Team-UwU-Robotics/Team-UwU/README.md

# Team-UwU
Official Repository for Team UwU
