Team-UwU-Robotics/Team-UwU/Eagle PCB/Partlist/Part-List.xlsm

Sheet: Layer 1
Qty | Value | Device | Package | Parts | Description | PROD_ID | SF_ID | SF_SKU | VALUE.1 | Column1
3 |  | 74HC4067SSOP-24 | SSOP24 | MUX_L1, MUX_L2, MUX_L3
1 |  | CONN_021X02_NO_SILK | 1X02_NO_SILK | LDR | Multi connection point. Often used as Generic Header-pin footprint for 0.1 inch spaced/style header connections
1 |  | CONN_02LOCK | 1X02_LOCK | J1 | Multi connection point. Often used as Generic Header-pin footprint for 0.1 inch spaced/style header connections
1 |  | CONN_02POLAR | MOLEX-1X2 | LED | Multi connection point. Often used as Generic Header-pin footprint for 0.1 inch spaced/style header connections |  | PRT-09918
1 |  | CONN_03LOCK | 1X03_LOCK | ESC_IN | Multi connection point. Often used as Generic Header-pin footprint for 0.1 inch spaced/style header connections
1 |  | CONN_08LOCK | 1X08_LOCK | MOUSE | Multi connection point. Often used as Generic Header-pin footprint for 0.1 inch spaced/style header connections
36 |  | LIGHT_SENSORALS | ALS-PT19 | Q1, Q2, Q3, Q4, Q5, Q6, Q7, Q8, Q9, Q10, Q11, Q12, Q13, Q14, Q15, Q16, Q17, Q18, Q19, Q20, Q21, Q22, Q23, Q24, Q25, Q26, Q27, Q28, Q29, Q30, Q31, Q32, Q33, Q34, Q35, Q36 | Ambient Light Sensors - Phototransistors | IC-11836 | SEN-12566
2 |  | SN74LVC2G04DBVR | SOT23-6 | MU1, MU2
2 |  | SWITCH-SPDT-PTH-11.6X4.0MM-LOCK | SWITCH_SPDT_PTH_11.6X4.0MM_LOCK | LS1, S3 | Single Pole, Double Throw (SPDT) Switch | SWCH-08261 |  | COM-00102
2 |  | TPS54X0 | POWERPAD-SOIC-8 | U1, U2
7 | 0.1uF | CAPACITOR0603 | C0603 | 1C5, 1C9, 2C1, 2C2, 2C3, 3C1, 3C2
4 | 1.0uF | CAPACITOR0603 | C0603 | M1C3, M2C3, M3C3, M4C3
16 | 10k | RESISTOR0603 | R0603 | 1R1, 1R3, M1R8, M1R9, M1R11, M2R8, M2R9, M2R11, M3R8, M3R9, M3R11, M4R8, M4R9, M4R11, R1, R4
3 | 10nF | CAPACITOR0603 | C0603 | 1C3, 1C8, C4
2 | 10uH | INDUCTORSWPA8040 | SWPA8040 | 1L1, 1L2
12 | 18AWG | 18AWG | 18AWG | GND_M2A, GND_M2B, GND_M4A, GND_M4B, V_BATT_M1A, V_BATT_M1B, V_BATT_M2A, V_BATT_M2B, V_BATT_M3A, V_BATT_M3B, V_BATT_M4A, V_BATT_M4B
29 | 1k | RESISTOR0603 | R0603 | 2R1, 2R2, 2R3, M1R1, M1R2, M1R5, M1R6, M1R7, M1R10, M2R1, M2R2, M2R5, M2R6, M2R7, M2R10, M3R1, M3R2, M3R5, M3R6, M3R7, M3R10, M4R1, M4R2, M4R5, M4R6, M4R7, M4R10, R2, R3
14 | 1uF | CAPACITOR0603 | C0603 | 2C4, 2C5, 2C6, C1, C2, C3, C5, C8, LC1, LC2, LC3, LC4, LC5, LC6
2 | 220uF | 100UF-POLAR-EIA7343-10V-10%(TANT) | EIA7343 | 1C4, 1C7 | 100ÂµF polarized capacitors | CAP-07890 |  |  | 100uF
2 | 22pF | CAPACITOR0603 | C0603 | C6, C7
2 | 22uF | CAPACITOR1210 | C1210 | 1C2, 1C10
1 | 2M | RESISTOR0603 | R0603 | R6
1 | 2k | RESISTOR0603 | R0603 | LG_R2
1 | 3.24k | RESISTOR0603 | R0603 | 1R4
8 | 3.3k | RESISTOR0603 | R0603 | M1R3, M1R4, M2R3, M2R4, M3R3, M3R4, M4R3, M4R4
2 | 30Î©/1.8A | FERRITE_BEAD-0603 | 0603 | FB1, FB2 | Ferrite Bead (blocks, cores, rings, chokes, etc.) | NDUC-13805 |  |  | 30Î©/1.8A
4 | 33nF | CAPACITOR0603 | C0603 | M1C1, M2C1, M3C1, M4C1
36 | 3528LED | 3528LED | 3528 | LD1, LD2, LD3, LD4, LD5, LD6, LD7, LD8, LD9, LD10, LD11, LD12, LD13, LD14, LD15, LD16, LD17, LD18, LD19, LD20, LD21, LD22, LD23, LD24, LD25, LD26, LD27, LD28, LD29, LD30, LD31, LD32, LD33, LD34, LD35, LD36
3 | 3k | RESISTOR0603 | R0603 | 2R4, 2R5, 2R6
6 | 4.7k | RESISTOR0603 | R0603 | M1R12, M2R12, M3R12, M4R12, R8, R9
2 | 4.7uF | CAPACITOR0603 | C0603 | 1C1, 1C6
1 | 47 | RESISTOR0603 | R0603 | LR1
1 | 470 | RESISTOR0603 | R0603 | R5
1 | 5.9k | RESISTOR0603 | R0603 | 1R2
1 | 500k | RESISTOR0603 | R0603 | R7
4 | 680uF | 3.5MM_CAP | 3.5MM_CAP | M1C2, M2C2, M3C2, M4C2
1 | 8MHz | CRYSTALSMD-5X3.2-2PAD | CRYSTAL-SMD-5X3.2-2PAD | Y1 | Crystals (Generic)
1 | AO3402 | MOSFET-NCH-AO3404A | SOT23-3 | Q37 | N-channel MOSFETs | TRANS-12988 |  |  | 5.8A/30V/35mÎ©
4 | AOD482 | MOSFET-NCH-FDD8780 | DPAK | M1Q1, M2Q1, M3Q1, M4Q1 | N-channel MOSFETs | TRANS-09984 |  |  | 35A/25V/8.5mÎ©
4 | BLUE | LED-BLUE0603 | LED-0603 | M1D2, M2D2, M3D2, M4D2 | Blue SMD LED | DIO-08575 |  |  | BLUE
1 | BLUE | LED0603 | LED-0603 | D1 | LED (Generic)
1 | CONN_07X2 | CONN_07X2 | 2X7 | U$15
2 | MOMENTARY_SWITCH_4X3 | MOMENTARY_SWITCH_4X3 | MOMENTARY_SWITCH_4X3 | BOOT, RST
4 | RED | LED-RED0603 | LED-0603 | M1D1, M2D1, M3D1, M4D1 | Red SMD LED | DIO-00819 |  |  | RED
1 | SM06B-SRSS-TB | SM06B-SRSS-TB | SM06B-SRSS-TB | X2 | JST SH series header 1.00mm pitch disconnectable crimp style connectors, horizontal (side entry type), 6 pins
2 | SS54 | DIODE-SCHOTTKY | SMA-DIODE | 1D1, 1D2
1 | STM32F103CBT6 | STM32F103CBT6 | LQFP48 | U$2
4 | VNH5019 | VNH5019 | POWERSO-30 | M_BL, M_BR, M_FL, M_FR
5 | XT30PB-F | XT30PB-F | XT30PB-F | ESC_OUT, M1J1, M2J1, M3J1, M4J1
1 | XT60XT60PB-M | XT60XT60PB-M | XT60PB-M | U$1

Sheet: Layer 3
Qty | Value | Device | Package | Parts | Description | PROD_ID | SF_SKU | VALUE.1 | Column1
24 |  | CAPACITOR0603 | C0603 | 3C1, 3C2, 3C3, 3C4, 3C5, 3C6, 3C7, 3C8, 3C9, 3C10, 3C11, 3C12, 3C13, 3C14, 3C15, 3C16, 3C17, 3C18, 3C19, 3C20, 3C21, 3C22, 3C23, 3C24
1 |  | CONN_02LOCK | 1X02_LOCK | J1 | Multi connection point. Often used as Generic Header-pin footprint for 0.1 inch spaced/style header connections
1 |  | CONN_03LOCK | 1X03_LOCK | SERVO_IO | Multi connection point. Often used as Generic Header-pin footprint for 0.1 inch spaced/style header connections
2 |  | SWITCH-SPDT-PTH-11.6X4.0MM-LOCK | SWITCH_SPDT_PTH_11.6X4.0MM_LOCK | 3V3_PWR, 5V_PWR | Single Pole, Double Throw (SPDT) Switch | SWCH-08261 | COM-00102
6 | 10k | RESISTOR0603 | R0603 | R1, R4, R6, R7, R8, R9
2 | 1k | RESISTOR0603 | R0603 | R2, R3
4 | 1uF | CAPACITOR0603 | C0603 | C1, C2, C3, C5
2 | 22pF | CAPACITOR0603 | C0603 | C6, C7
2 | 4.7k | RESISTOR0603 | R0603 | R12, R13
1 | 470 | RESISTOR0603 | R0603 | R5
1 | 8MHz | CRYSTALSMD-5X3.2-2PAD | CRYSTAL-SMD-5X3.2-2PAD | Y1 | Crystals (Generic)
1 | AO3402 | MOSFET-NCH-AO3404A | SOT23-3 | Q2 | N-channel MOSFETs | TRANS-12988 |  | 5.8A/30V/35mÎ©
1 | BLUE | LED0603 | LED-0603 | D1 | LED (Generic)
1 | CONN_07X2 | CONN_07X2 | 2X7 | U$14
1 | DIP-04SMD | DIP-04SMD | DIPSWITCH-04-SMD | S1 | 4-Position DIP Switch
1 | HC-05 | HC-05 | HC-05 | BLUETOOTH
2 | MOMENTARY_SWITCH_4X3 | MOMENTARY_SWITCH_4X3 | MOMENTARY_SWITCH_4X3 | BOOT, RST
1 | OPENMV3 | OPENMV3 | OPENMV3 | U$8
1 | SM04B-SRSS-TB | SM04B-SRSS-TB | SM04B-SRSS-TB | 4TH_LAYER | JST SH series header 1.00mm pitch disconnectable crimp style connectors, horizontal (side entry type), 4 pins
1 | SM06B-SRSS-TB | SM06B-SRSS-TB | SM06B-SRSS-TB | X1 | JST SH series header 1.00mm pitch disconnectable crimp style connectors, horizontal (side entry type), 6 pins
1 | STM32F103CBT6 | STM32F103CBT6 | LQFP48 | STM32_IR
1 | TEENSY_3.5/3.6_NO_MIDDLE | TEENSY_3.5/3.6_NO_MIDDLE | TEENSY_3.5/3.6_NO_MIDDLE | U$1
24 | TSSP58038 | TSSP58038 | TSSP58038 | 3U1, 3U2, 3U3, 3U4, 3U5, 3U6, 3U7, 3U8, 3U9, 3U10, 3U11, 3U12, 3U13, 3U14, 3U15, 3U16, 3U17, 3U18, 3U19, 3U20, 3U21, 3U22, 3U23, 3U24

Sheet: Layer 4
Qty | Value | Device | Package | Parts | Description | PROD_ID | SF_SKU | Column1
16 |  | LED0603 | LED-0603 | 1D1, 1D2, 1D3, 1D4, 1D5, 1D6, 1D7, 1D8, 1D9, 1D10, 1D11, 1D12, 1D13, 1D14, 1D15, 1D16 | LED (Generic)
1 |  | SWITCH-SPDT-PTH-11.6X4.0MM-LOCK | SWITCH_SPDT_PTH_11.6X4.0MM_LOCK | 3V3_PWR | Single Pole, Double Throw (SPDT) Switch | SWCH-08261 | COM-00102
2 | 10k | RESISTOR0603 | R0603 | R1, R4
3 | 1k | RESISTOR0603 | R0603 | R2, R3, R5
4 | 1uF | CAPACITOR0603 | C0603 | C1, C2, C3, C5
2 | 22pF | CAPACITOR0603 | C0603 | C6, C7
8 | 470 | RESISTOR0603 | R0603 | 1R1, 1R2, 1R3, 1R4, 1R5, 1R6, 1R7, 1R8
1 | 8MHz | CRYSTALSMD-5X3.2-2PAD | CRYSTAL-SMD-5X3.2-2PAD | Y1 | Crystals (Generic)
1 | BLUE | LED0603 | LED-0603 | D1 | LED (Generic)
1 | BNO055 | BNO055 | BNO055 | COMPASS
3 | MOMENTARY_SWITCH_4X3 | MOMENTARY_SWITCH_4X3 | MOMENTARY_SWITCH_4X3 | BNO_RESET, BOOT, RST
1 | SM04B-SRSS-TB | SM04B-SRSS-TB | SM04B-SRSS-TB | 3RD_LAYER | JST SH series header 1.00mm pitch disconnectable crimp style connectors, horizontal (side entry type), 4 pins
1 | SM06B-SRSS-TB | SM06B-SRSS-TB | SM06B-SRSS-TB | X1 | JST SH series header 1.00mm pitch disconnectable crimp style connectors, horizontal (side entry type), 6 pins
1 | STM32F103CBT6 | STM32F103CBT6 | LQFP48 | STM32
4 | VL53L1X | VL53L1X | VL53L1X_SLANTEDPINS | TOF1, TOF2, TOF3, TOF4

Sheet: Layer 1-F
Part No | Description | Package | Unit Price | Qty | Total Qty | Total Price | Product Link | Remarks
100UF-POLAR-EIA7343-10V-10%(TANT) | 220uF | EIA7343 |  | 2 | 4
18AWG | 18AWG | 18AWG |  | 12 | 24
3.5MM_CAP | 680uF | 3.5MM_CAP |  | 4 | 8
3528LED | 3528LED | 3528 |  | 36 | 72
74HC4067SSOP-24 |  | SSOP24 |  | 3 | 6
CAPACITOR0603 | 0.1uF | C0603 |  | 7 | 14
CAPACITOR0603 | 1.0uF | C0603 |  | 4 | 8
CAPACITOR0603 | 10nF | C0603 |  | 3 | 6
CAPACITOR0603 | 1uF | C0603 |  | 14 | 28
CAPACITOR0603 | 22pF | C0603 |  | 2 | 4
CAPACITOR0603 | 33nF | C0603 |  | 4 | 8
CAPACITOR0603 | 4.7uF | C0603 |  | 2 | 4
CAPACITOR1210 | 22uF | C1210 |  | 2 | 4
CONN_021X02_NO_SILK |  | 1X02_NO_SILK |  | 1 | 2
CONN_02LOCK |  | 1X02_LOCK |  | 1 | 2
CONN_02POLAR |  | MOLEX-1X2 |  | 1 | 2
CONN_03LOCK |  | 1X03_LOCK |  | 1 | 2
CONN_07X2 | CONN_07X2 | 2X7 |  | 1 | 2
CONN_08LOCK |  | 1X08_LOCK |  | 1 | 2
CRYSTALSMD-5X3.2-2PAD | 8MHz | CRYSTAL-SMD-5X3.2-2PAD |  | 1 | 2
DIODE-SCHOTTKY | SS54 | SMA-DIODE |  | 2 | 4
FERRITE_BEAD-0603 | 30Î©/1.8A | 0603 |  | 2 | 4
INDUCTORSWPA8040 | 10uH | SWPA8040 |  | 2 | 4
LED0603 | BLUE | LED-0603 |  | 1 | 2
LED-BLUE0603 | BLUE | LED-0603 |  | 4 | 8
LED-RED0603 | RED | LED-0603 |  | 4 | 8
LIGHT_SENSORALS |  | ALS-PT19 |  | 36 | 72
MOMENTARY_SWITCH_4X3 | MOMENTARY_SWITCH_4X3 | MOMENTARY_SWITCH_4X3 |  | 2 | 4
MOSFET-NCH-AO3404A | AO3402 | SOT23-3 |  | 1 | 2
MOSFET-NCH-FDD8780 | AOD482 | DPAK |  | 4 | 8
RESISTOR0603 | 10k | R0603 |  | 16 | 32
RESISTOR0603 | 1k | R0603 |  | 29 | 58
RESISTOR0603 | 2M | R0603 |  | 1 | 2
RESISTOR0603 | 2k | R0603 |  | 1 | 2
RESISTOR0603 | 3.24k | R0603 |  | 1 | 2
RESISTOR0603 | 3.3k | R0603 |  | 8 | 16
RESISTOR0603 | 3k | R0603 |  | 3 | 6
RESISTOR0603 | 4.7k | R0603 |  | 6 | 12
RESISTOR0603 | 47 | R0603 |  | 1 | 2
RESISTOR0603 | 470 | R0603 |  | 1 | 2
RESISTOR0603 | 5.9k | R0603 |  | 1 | 2
RESISTOR0603 | 500k | R0603 |  | 1 | 2
SM06B-SRSS-TB | SM06B-SRSS-TB | SM06B-SRSS-TB |  | 1 | 2
SN74LVC2G04DBVR |  | SOT23-6 |  | 2 | 4
STM32F103CBT6 | STM32F103CBT6 | LQFP48 |  | 1 | 2
SWITCH-SPDT-PTH-11.6X4.0MM-LOCK |  | SWITCH_SPDT_PTH_11.6X4.0MM_LOCK |  | 2 | 4
TPS54X0 |  | POWERPAD-SOIC-8 |  | 2 | 4
VNH5019 | VNH5019 | POWERSO-30 |  | 4 | 8
XT30PB-F | XT30PB-F | XT30PB-F |  | 5 | 10
XT60XT60PB-M | XT60XT60PB-M | XT60PB-M |  | 1 | 2

Sheet: Layer 3-F
Part No | Description | Package | Unit Price | Qty | Total Qty | Total Price | Product Link | Remarks
CAPACITOR0603 |  | C0603 |  | 24 | 48
CAPACITOR0603 | 1uF | C0603 |  | 4 | 8
CAPACITOR0603 | 22pF | C0603 |  | 2 | 4
CONN_02LOCK |  | 1X02_LOCK |  | 1 | 2
CONN_03LOCK |  | 1X03_LOCK |  | 1 | 2
CONN_07X2 | CONN_07X2 | 2X7 |  | 1 | 2
CRYSTALSMD-5X3.2-2PAD | 8MHz | CRYSTAL-SMD-5X3.2-2PAD |  | 1 | 2
DIP-04SMD | DIP-04SMD | DIPSWITCH-04-SMD |  | 1 | 2
HC-05 | HC-05 | HC-05 |  | 1 | 2
LED0603 | BLUE | LED-0603 |  | 1 | 2
MOMENTARY_SWITCH_4X3 | MOMENTARY_SWITCH_4X3 | MOMENTARY_SWITCH_4X3 |  | 2 | 4
MOSFET-NCH-AO3404A | AO3402 | SOT23-3 |  | 1 | 2
OPENMV3 | OPENMV3 | OPENMV3 |  | 1 | 2
RESISTOR0603 | 10k | R0603 |  | 6 | 12
RESISTOR0603 | 1k | R0603 |  | 2 | 4
RESISTOR0603 | 4.7k | R0603 |  | 2 | 4
RESISTOR0603 | 470 | R0603 |  | 1 | 2
SM04B-SRSS-TB | SM04B-SRSS-TB | SM04B-SRSS-TB |  | 1 | 2
SM06B-SRSS-TB | SM06B-SRSS-TB | SM06B-SRSS-TB |  | 1 | 2
STM32F103CBT6 | STM32F103CBT6 | LQFP48 |  | 1 | 2
SWITCH-SPDT-PTH-11.6X4.0MM-LOCK |  | SWITCH_SPDT_PTH_11.6X4.0MM_LOCK |  | 2 | 4
TEENSY_3.5/3.6_NO_MIDDLE | TEENSY_3.5/3.6_NO_MIDDLE | TEENSY_3.5/3.6_NO_MIDDLE |  | 1 | 2
TSSP58038 | TSSP58038 | TSSP58038 |  | 24 | 48

Sheet: Layer 4-F
Part No | Description | Package | Unit Price | Qty | Total Qty | Total Price | Product Link | Remarks
BNO055 | BNO055 | BNO055 |  | 1 | 2
CAPACITOR0603 | 1uF | C0603 |  | 4 | 8
CAPACITOR0603 | 22pF | C0603 |  | 2 | 4
CRYSTALSMD-5X3.2-2PAD | 8MHz | CRYSTAL-SMD-5X3.2-2PAD |  | 1 | 2
LED0603 |  | LED-0603 |  | 16 | 32
LED0603 | BLUE | LED-0603 |  | 1 | 2
MOMENTARY_SWITCH_4X3 | MOMENTARY_SWITCH_4X3 | MOMENTARY_SWITCH_4X3 |  | 3 | 6
RESISTOR0603 | 10k | R0603 |  | 2 | 4
RESISTOR0603 | 1k | R0603 |  | 3 | 6
RESISTOR0603 | 470 | R0603 |  | 8 | 16
SM04B-SRSS-TB | SM04B-SRSS-TB | SM04B-SRSS-TB |  | 1 | 2
SM06B-SRSS-TB | SM06B-SRSS-TB | SM06B-SRSS-TB |  | 1 | 2
STM32F103CBT6 | STM32F103CBT6 | LQFP48 |  | 1 | 2
SWITCH-SPDT-PTH-11.6X4.0MM-LOCK |  | SWITCH_SPDT_PTH_11.6X4.0MM_LOCK |  | 1 | 2
VL53L1X | VL53L1X | VL53L1X_SLANTEDPINS |  | 4 | 8

Sheet: Sheet2
 |  |  |  | Values
Part No | Description | Package | Unit Price | Sum of Qty | Sum of Total Qty
100UF-POLAR-EIA7343-10V-10%(TANT) | 220uF | EIA7343 | (blank) | 2 | 4
100UF-POLAR-EIA7343-10V-10%(TANT) Total |  |  |  | 2 | 4
18AWG | 18AWG | 18AWG | (blank) | 12 | 24
18AWG Total |  |  |  | 12 | 24
3.5MM_CAP | 680uF | 3.5MM_CAP | (blank) | 4 | 8
3.5MM_CAP Total |  |  |  | 4 | 8
3528LED | 3528LED | 3528 | (blank) | 36 | 72
3528LED Total |  |  |  | 36 | 72
74HC4067SSOP-24 |  | SSOP24 | (blank) | 3 | 6
74HC4067SSOP-24 Total |  |  |  | 3 | 6
BNO055 | BNO055 | BNO055 | (blank) | 1 | 2
BNO055 Total |  |  |  | 1 | 2
CAPACITOR0603 |  | C0603 | (blank) | 24 | 48
 | 0.1uF | C0603 | (blank) | 7 | 14
 | 1.0uF | C0603 | (blank) | 4 | 8
 | 10nF | C0603 | (blank) | 3 | 6
 | 1uF | C0603 | (blank) | 22 | 44
 | 22pF | C0603 | (blank) | 6 | 12
 | 33nF | C0603 | (blank) | 4 | 8
 | 4.7uF | C0603 | (blank) | 2 | 4
CAPACITOR0603 Total |  |  |  | 72 | 144
CAPACITOR1210 | 22uF | C1210 | (blank) | 2 | 4
CAPACITOR1210 Total |  |  |  | 2 | 4
CONN_021X02_NO_SILK |  | 1X02_NO_SILK | (blank) | 1 | 2
CONN_021X02_NO_SILK Total |  |  |  | 1 | 2
CONN_02LOCK |  | 1X02_LOCK | (blank) | 2 | 4
CONN_02LOCK Total |  |  |  | 2 | 4
CONN_02POLAR |  | MOLEX-1X2 | (blank) | 1 | 2
CONN_02POLAR Total |  |  |  | 1 | 2
CONN_03LOCK |  | 1X03_LOCK | (blank) | 2 | 4
CONN_03LOCK Total |  |  |  | 2 | 4
CONN_07X2 | CONN_07X2 | 2X7 | (blank) | 2 | 4
CONN_07X2 Total |  |  |  | 2 | 4
CONN_08LOCK |  | 1X08_LOCK | (blank) | 1 | 2
CONN_08LOCK Total |  |  |  | 1 | 2
CRYSTALSMD-5X3.2-2PAD | 8MHz | CRYSTAL-SMD-5X3.2-2PAD | (blank) | 3 | 6
CRYSTALSMD-5X3.2-2PAD Total |  |  |  | 3 | 6
DIODE-SCHOTTKY | SS54 | SMA-DIODE | (blank) | 2 | 4
DIODE-SCHOTTKY Total |  |  |  | 2 | 4
DIP-04SMD | DIP-04SMD | DIPSWITCH-04-SMD | (blank) | 1 | 2
DIP-04SMD Total |  |  |  | 1 | 2
FERRITE_BEAD-0603 | 30Î©/1.8A | 0603 | (blank) | 2 | 4
FERRITE_BEAD-0603 Total |  |  |  | 2 | 4
HC-05 | HC-05 | HC-05 | (blank) | 1 | 2
HC-05 Total |  |  |  | 1 | 2
INDUCTORSWPA8040 | 10uH | SWPA8040 | (blank) | 2 | 4
INDUCTORSWPA8040 Total |  |  |  | 2 | 4
LED0603 |  | LED-0603 | (blank) | 16 | 32
 | BLUE | LED-0603 | (blank) | 3 | 6
LED0603 Total |  |  |  | 19 | 38
LED-BLUE0603 | BLUE | LED-0603 | (blank) | 4 | 8
LED-BLUE0603 Total |  |  |  | 4 | 8
LED-RED0603 | RED | LED-0603 | (blank) | 4 | 8
LED-RED0603 Total |  |  |  | 4 | 8
LIGHT_SENSORALS |  | ALS-PT19 | (blank) | 36 | 72
LIGHT_SENSORALS Total |  |  |  | 36 | 72
MOMENTARY_SWITCH_4X3 | MOMENTARY_SWITCH_4X3 | MOMENTARY_SWITCH_4X3 | (blank) | 7 | 14
MOMENTARY_SWITCH_4X3 Total |  |  |  | 7 | 14
MOSFET-NCH-AO3404A | AO3402 | SOT23-3 | (blank) | 2 | 4
MOSFET-NCH-AO3404A Total |  |  |  | 2 | 4
MOSFET-NCH-FDD8780 | AOD482 | DPAK | (blank) | 4 | 8
MOSFET-NCH-FDD8780 Total |  |  |  | 4 | 8
OPENMV3 | OPENMV3 | OPENMV3 | (blank) | 1 | 2
OPENMV3 Total |  |  |  | 1 | 2
RESISTOR0603 | 10k | R0603 | (blank) | 24 | 48
 | 1k | R0603 | (blank) | 34 | 68
 | 2k | R0603 | (blank) | 1 | 2
 | 2M | R0603 | (blank) | 1 | 2
 | 3.24k | R0603 | (blank) | 1 | 2
 | 3.3k | R0603 | (blank) | 8 | 16
 | 3k | R0603 | (blank) | 3 | 6
 | 4.7k | R0603 | (blank) | 8 | 16
 | 47 | R0603 | (blank) | 1 | 2
 | 470 | R0603 | (blank) | 10 | 20
 | 5.9k | R0603 | (blank) | 1 | 2
 | 500k | R0603 | (blank) | 1 | 2
RESISTOR0603 Total |  |  |  | 93 | 186
SM04B-SRSS-TB | SM04B-SRSS-TB | SM04B-SRSS-TB | (blank) | 2 | 4
SM04B-SRSS-TB Total |  |  |  | 2 | 4
SM06B-SRSS-TB | SM06B-SRSS-TB | SM06B-SRSS-TB | (blank) | 3 | 6
SM06B-SRSS-TB Total |  |  |  | 3 | 6
SN74LVC2G04DBVR |  | SOT23-6 | (blank) | 2 | 4
SN74LVC2G04DBVR Total |  |  |  | 2 | 4
STM32F103CBT6 | STM32F103CBT6 | LQFP48 | (blank) | 3 | 6
STM32F103CBT6 Total |  |  |  | 3 | 6
SWITCH-SPDT-PTH-11.6X4.0MM-LOCK |  | SWITCH_SPDT_PTH_11.6X4.0MM_LOCK | (blank) | 5 | 10
SWITCH-SPDT-PTH-11.6X4.0MM-LOCK Total |  |  |  | 5 | 10
TEENSY_3.5/3.6_NO_MIDDLE | TEENSY_3.5/3.6_NO_MIDDLE | TEENSY_3.5/3.6_NO_MIDDLE | (blank) | 1 | 2
TEENSY_3.5/3.6_NO_MIDDLE Total |  |  |  | 1 | 2
TPS54X0 |  | POWERPAD-SOIC-8 | (blank) | 2 | 4
TPS54X0 Total |  |  |  | 2 | 4
TSSP58038 | TSSP58038 | TSSP58038 | (blank) | 24 | 48
TSSP58038 Total |  |  |  | 24 | 48
VL53L1X | VL53L1X | VL53L1X_SLANTEDPINS | (blank) | 4 | 8
VL53L1X Total |  |  |  | 4 | 8
VNH5019 | VNH5019 | POWERSO-30 | (blank) | 4 | 8
VNH5019 Total |  |  |  | 4 | 8
XT30PB-F | XT30PB-F | XT30PB-F | (blank) | 5 | 10
XT30PB-F Total |  |  |  | 5 | 10
XT60XT60PB-M | XT60XT60PB-M | XT60PB-M | (blank) | 1 | 2
XT60XT60PB-M Total |  |  |  | 1 | 2
Grand Total |  |  |  | 378 | 756

Sheet: Sheet1
Part No | Description | Package | Unit Price | Qty | Total Qty | Total Price | Product Link | Remarks
100UF-POLAR-EIA7343-10V-10%(TANT) | 220uF | EIA7343 |  | 2 | 4
18AWG | 18AWG | 18AWG |  | 12 | 24
3.5MM_CAP | 680uF | 3.5MM_CAP |  | 4 | 8
3528LED | 3528LED | 3528 |  | 36 | 72
74HC4067SSOP-24 |  | SSOP24 |  | 3 | 6
CAPACITOR0603 | 0.1uF | C0603 |  | 7 | 14
CAPACITOR0603 | 1.0uF | C0603 |  | 4 | 8
CAPACITOR0603 | 10nF | C0603 |  | 3 | 6
CAPACITOR0603 | 1uF | C0603 |  | 14 | 28
CAPACITOR0603 | 22pF | C0603 |  | 2 | 4
CAPACITOR0603 | 33nF | C0603 |  | 4 | 8
CAPACITOR0603 | 4.7uF | C0603 |  | 2 | 4
CAPACITOR1210 | 22uF | C1210 |  | 2 | 4
CONN_021X02_NO_SILK |  | 1X02_NO_SILK |  | 1 | 2
CONN_02LOCK |  | 1X02_LOCK |  | 1 | 2
CONN_02POLAR |  | MOLEX-1X2 |  | 1 | 2
CONN_03LOCK |  | 1X03_LOCK |  | 1 | 2
CONN_07X2 | CONN_07X2 | 2X7 |  | 1 | 2
CONN_08LOCK |  | 1X08_LOCK |  | 1 | 2
CRYSTALSMD-5X3.2-2PAD | 8MHz | CRYSTAL-SMD-5X3.2-2PAD |  | 1 | 2
DIODE-SCHOTTKY | SS54 | SMA-DIODE |  | 2 | 4
FERRITE_BEAD-0603 | 30Î©/1.8A | 0603 |  | 2 | 4
INDUCTORSWPA8040 | 10uH | SWPA8040 |  | 2 | 4
LED0603 | BLUE | LED-0603 |  | 1 | 2
LED-BLUE0603 | BLUE | LED-0603 |  | 4 | 8
LED-RED0603 | RED | LED-0603 |  | 4 | 8
LIGHT_SENSORALS |  | ALS-PT19 |  | 36 | 72
MOMENTARY_SWITCH_4X3 | MOMENTARY_SWITCH_4X3 | MOMENTARY_SWITCH_4X3 |  | 2 | 4
MOSFET-NCH-AO3404A | AO3402 | SOT23-3 |  | 1 | 2
MOSFET-NCH-FDD8780 | AOD482 | DPAK |  | 4 | 8
RESISTOR0603 | 10k | R0603 |  | 16 | 32
RESISTOR0603 | 1k | R0603 |  | 29 | 58
RESISTOR0603 | 2M | R0603 |  | 1 | 2
RESISTOR0603 | 2k | R0603 |  | 1 | 2
RESISTOR0603 | 3.24k | R0603 |  | 1 | 2
RESISTOR0603 | 3.3k | R0603 |  | 8 | 16
RESISTOR0603 | 3k | R0603 |  | 3 | 6
RESISTOR0603 | 4.7k | R0603 |  | 6 | 12
RESISTOR0603 | 47 | R0603 |  | 1 | 2
RESISTOR0603 | 470 | R0603 |  | 1 | 2
RESISTOR0603 | 5.9k | R0603 |  | 1 | 2
RESISTOR0603 | 500k | R0603 |  | 1 | 2
SM06B-SRSS-TB | SM06B-SRSS-TB | SM06B-SRSS-TB |  | 1 | 2
SN74LVC2G04DBVR |  | SOT23-6 |  | 2 | 4
STM32F103CBT6 | STM32F103CBT6 | LQFP48 |  | 1 | 2
SWITCH-SPDT-PTH-11.6X4.0MM-LOCK |  | SWITCH_SPDT_PTH_11.6X4.0MM_LOCK |  | 2 | 4
TPS54X0 |  | POWERPAD-SOIC-8 |  | 2 | 4
VNH5019 | VNH5019 | POWERSO-30 |  | 4 | 8
XT30PB-F | XT30PB-F | XT30PB-F |  | 5 | 10
XT60XT60PB-M | XT60XT60PB-M | XT60PB-M |  | 1 | 2
CAPACITOR0603 |  | C0603 |  | 24 | 48
CAPACITOR0603 | 1uF | C0603 |  | 4 | 8
CAPACITOR0603 | 22pF | C0603 |  | 2 | 4
CONN_02LOCK |  | 1X02_LOCK |  | 1 | 2
CONN_03LOCK |  | 1X03_LOCK |  | 1 | 2
CONN_07X2 | CONN_07X2 | 2X7 |  | 1 | 2
CRYSTALSMD-5X3.2-2PAD | 8MHz | CRYSTAL-SMD-5X3.2-2PAD |  | 1 | 2
DIP-04SMD | DIP-04SMD | DIPSWITCH-04-SMD |  | 1 | 2
HC-05 | HC-05 | HC-05 |  | 1 | 2
LED0603 | BLUE | LED-0603 |  | 1 | 2
MOMENTARY_SWITCH_4X3 | MOMENTARY_SWITCH_4X3 | MOMENTARY_SWITCH_4X3 |  | 2 | 4
MOSFET-NCH-AO3404A | AO3402 | SOT23-3 |  | 1 | 2
OPENMV3 | OPENMV3 | OPENMV3 |  | 1 | 2
RESISTOR0603 | 10k | R0603 |  | 6 | 12
RESISTOR0603 | 1k | R0603 |  | 2 | 4
RESISTOR0603 | 4.7k | R0603 |  | 2 | 4
RESISTOR0603 | 470 | R0603 |  | 1 | 2
SM04B-SRSS-TB | SM04B-SRSS-TB | SM04B-SRSS-TB |  | 1 | 2
SM06B-SRSS-TB | SM06B-SRSS-TB | SM06B-SRSS-TB |  | 1 | 2
STM32F103CBT6 | STM32F103CBT6 | LQFP48 |  | 1 | 2
SWITCH-SPDT-PTH-11.6X4.0MM-LOCK |  | SWITCH_SPDT_PTH_11.6X4.0MM_LOCK |  | 2 | 4
TEENSY_3.5/3.6_NO_MIDDLE | TEENSY_3.5/3.6_NO_MIDDLE | TEENSY_3.5/3.6_NO_MIDDLE |  | 1 | 2
TSSP58038 | TSSP58038 | TSSP58038 |  | 24 | 48
BNO055 | BNO055 | BNO055 |  | 1 | 2
CAPACITOR0603 | 1uF | C0603 |  | 4 | 8
CAPACITOR0603 | 22pF | C0603 |  | 2 | 4
CRYSTALSMD-5X3.2-2PAD | 8MHz | CRYSTAL-SMD-5X3.2-2PAD |  | 1 | 2
LED0603 |  | LED-0603 |  | 16 | 32
LED0603 | BLUE | LED-0603 |  | 1 | 2
MOMENTARY_SWITCH_4X3 | MOMENTARY_SWITCH_4X3 | MOMENTARY_SWITCH_4X3 |  | 3 | 6
RESISTOR0603 | 10k | R0603 |  | 2 | 4
RESISTOR0603 | 1k | R0603 |  | 3 | 6
RESISTOR0603 | 470 | R0603 |  | 8 | 16
SM04B-SRSS-TB | SM04B-SRSS-TB | SM04B-SRSS-TB |  | 1 | 2
SM06B-SRSS-TB | SM06B-SRSS-TB | SM06B-SRSS-TB |  | 1 | 2
STM32F103CBT6 | STM32F103CBT6 | LQFP48 |  | 1 | 2
SWITCH-SPDT-PTH-11.6X4.0MM-LOCK |  | SWITCH_SPDT_PTH_11.6X4.0MM_LOCK |  | 1 | 2
VL53L1X | VL53L1X | VL53L1X_SLANTEDPINS |  | 4 | 8
