Team-UwU-Robotics/Team-UwU/Eagle PCB/Layer 3.brd

## EAGLE design Eagle PCB/Layer 3.brd (2021-03-01)

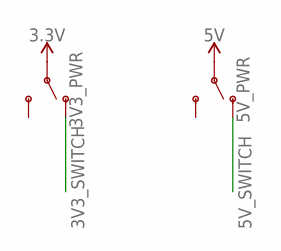
[picture p1: schematic Layer 3.sch, sheet 1]

Parts:
3V3_PWR, 5V_PWR: SWITCH-SPDT-PTH-11.6X4.0MM-LOCK; SWITCH_SPDT_PTH_11.6X4.0MM_LOCK

Connections:
3.3V: 3V3_PWR.2; also elsewhere on the board
3V3_SWITCH: 3V3_PWR.1 (O); also elsewhere on the board
5V: 5V_PWR.2; also elsewhere on the board
5V_SWITCH: 5V_PWR.1 (O); also elsewhere on the board

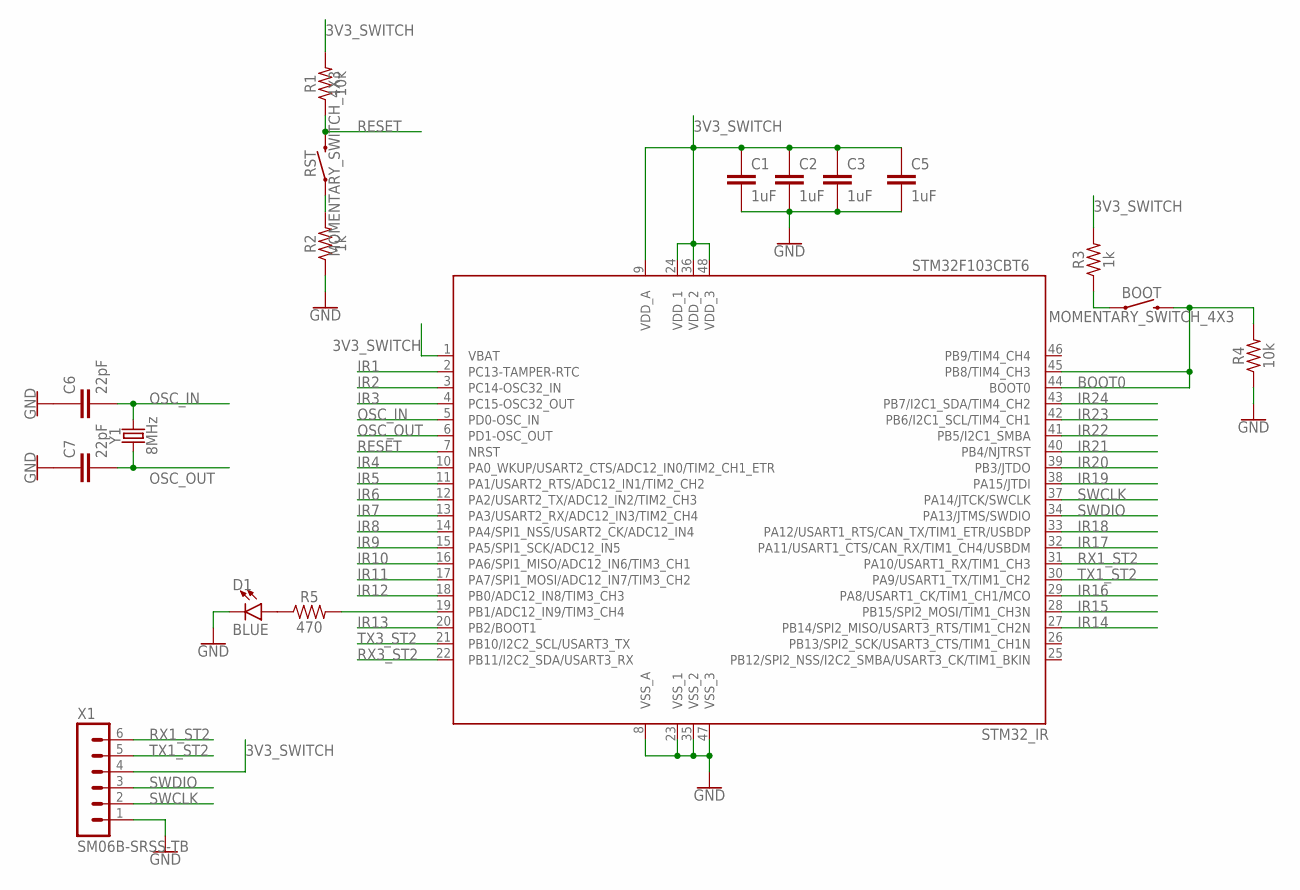
[picture p2: schematic Layer 3.sch, sheet 2]

Parts:
BOOT: MOMENTARY_SWITCH_4X3
C1, C2, C3, C5: 1uF; C0603
C6, C7: 22pF; C0603
D1: BLUE; LED-0603
R1, R4: 10k; R0603
R2, R3: 1k; R0603
R5: 470; R0603
RST: MOMENTARY_SWITCH_4X3
STM32_IR: STM32F103CBT6; LQFP48
X1: SM06B-SRSS-TB
Y1: 8MHz; CRYSTAL-SMD-5X3.2-2PAD

Connections:
3V3_SWITCH: C1.1, C2.1, C3.1, C5.2, R1.2, R3.2, STM32_IR.1 (VBAT), STM32_IR.9 (VDD_A), STM32_IR.24 (VDD_1), STM32_IR.36 (VDD_2), STM32_IR.48 (VDD_3), X1.4; also elsewhere on the board
BOOT0: BOOT.P$2 (2), R4.2, STM32_IR.44 (BOOT0), STM32_IR.45 (PB8/TIM4_CH3)
GND: C1.2, C2.2, C3.2, C5.1, C6.1, C7.1, D1.C, R2.1, R4.1, STM32_IR.8 (VSS_A), STM32_IR.23 (VSS_1), STM32_IR.35 (VSS_2), STM32_IR.47 (VSS_3), X1.1; also elsewhere on the board
IR1: STM32_IR.2 (PC13-TAMPER-RTC); also elsewhere on the board
IR2: STM32_IR.3 (PC14-OSC32_IN); also elsewhere on the board
IR3: STM32_IR.4 (PC15-OSC32_OUT); also elsewhere on the board
IR4: STM32_IR.10 (PA0_WKUP/USART2_CTS/ADC12_IN0/TIM2_CH1_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); also elsewhere on the board
IR5: STM32_IR.11 (PA1/USART2_RTS/ADC12_IN1/TIM2_CH2); also elsewhere on the board
IR6: STM32_IR.12 (PA2/USART2_TX/ADC12_IN2/TIM2_CH3); also elsewhere on the board
IR7: STM32_IR.13 (PA3/USART2_RX/ADC12_IN3/TIM2_CH4); also elsewhere on the board
IR8: STM32_IR.14 (PA4/SPI1_NSS/USART2_CK/ADC12_IN4); also elsewhere on the board
IR9: STM32_IR.15 (PA5/SPI1_SCK/ADC12_IN5); also elsewhere on the board
IR10: STM32_IR.16 (PA6/SPI1_MISO/ADC12_IN6/TIM3_CH1); also elsewhere on the board
IR11: STM32_IR.17 (PA7/SPI1_MOSI/ADC12_IN7/TIM3_CH2); also elsewhere on the board
IR12: STM32_IR.18 (PB0/ADC12_IN8/TIM3_CH3); also elsewhere on the board
IR13: STM32_IR.20 (PB2/BOOT1); also elsewhere on the board
IR14: STM32_IR.27 (PB14/SPI2_MISO/USART3_RTS/TIM1_CH2N); also elsewhere on the board
IR15: STM32_IR.28 (PB15/SPI2_MOSI/TIM1_CH3N); also elsewhere on the board
IR16: STM32_IR.29 (PA8/USART1_CK/TIM1_CH1/MCO); also elsewhere on the board
IR17: STM32_IR.32 (PA11/USART1_CTS/CAN_RX/TIM1_CH4/USBDM); also elsewhere on the board
IR18: STM32_IR.33 (PA12/USART1_RTS/CAN_TX/TIM1_ETR/USBDP); also elsewhere on the board
IR19: STM32_IR.38 (PA15/JTDI); also elsewhere on the board
IR20: STM32_IR.39 (PB3/JTDO); also elsewhere on the board
IR21: STM32_IR.40 (PB4/NJTRST); also elsewhere on the board
IR22: STM32_IR.41 (PB5/I2C1_SMBA); also elsewhere on the board
IR23: STM32_IR.42 (PB6/I2C1_SCL/TIM4_CH1); also elsewhere on the board
IR24: STM32_IR.43 (PB7/I2C1_SDA/TIM4_CH2); also elsewhere on the board
unnamed: R2.2, RST.P$1 (1)
unnamed: BOOT.P$1 (1), R3.1
unnamed: R5.2, STM32_IR.19 (PB1/ADC12_IN9/TIM3_CH4)
unnamed: D1.A, R5.1
OSC_IN: C6.2, STM32_IR.5 (PD0-OSC_IN), Y1.P$2 (2)
OSC_OUT: C7.2, STM32_IR.6 (PD1-OSC_OUT), Y1.P$1 (1)
RESET: R1.1, RST.P$2 (2), STM32_IR.7 (NRST)
RX1_ST2: STM32_IR.31 (PA10/USART1_RX/TIM1_CH3), X1.6; also elsewhere on the board
RX3_ST2: STM32_IR.22 (PB11/I2C2_SDA/USART3_RX)
SWCLK: STM32_IR.37 (PA14/JTCK/SWCLK), X1.2
SWDIO: STM32_IR.34 (PA13/JTMS/SWDIO), X1.3
TX1_ST2: STM32_IR.30 (PA9/USART1_TX/TIM1_CH2), X1.5; also elsewhere on the board
TX3_ST2: STM32_IR.21 (PB10/I2C2_SCL/USART3_TX)

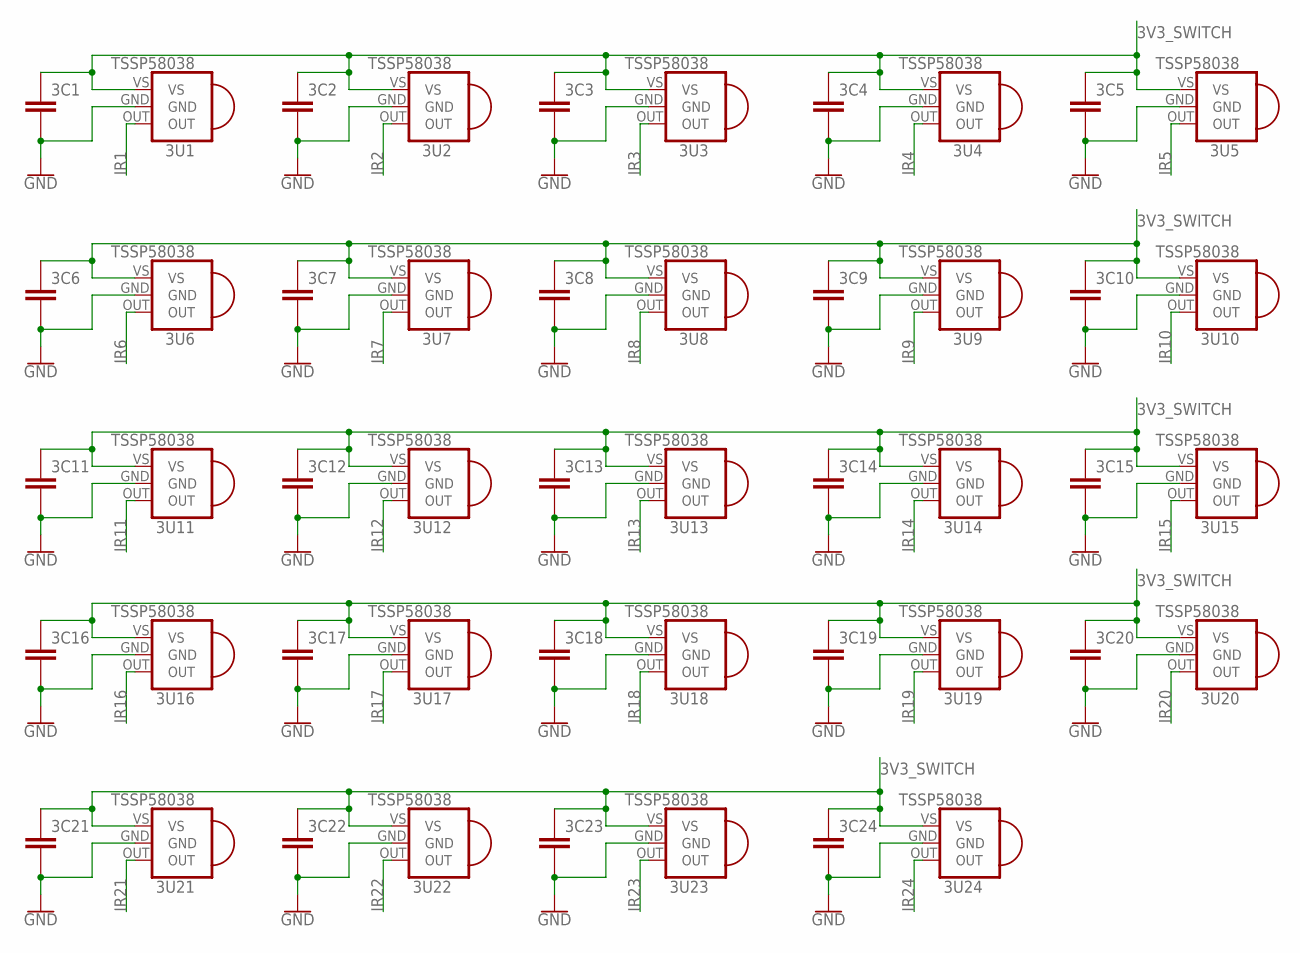
[picture p3: schematic Layer 3.sch, sheet 3]

Parts:
3C1, 3C2, 3C3, 3C4, 3C5, 3C6, 3C7, 3C8, 3C9, 3C10, 3C11, 3C12, 3C13, 3C14, 3C15, 3C16, 3C17, 3C18, 3C19, 3C20, 3C21, 3C22, 3C23, 3C24: CAPACITOR0603; C0603
3U1, 3U2, 3U3, 3U4, 3U5, 3U6, 3U7, 3U8, 3U9, 3U10, 3U11, 3U12, 3U13, 3U14, 3U15, 3U16, 3U17, 3U18, 3U19, 3U20, 3U21, 3U22, 3U23, 3U24: TSSP58038

Connections:
3V3_SWITCH: 3C1.1, 3C2.1, 3C3.1, 3C4.1, 3C5.1, 3C6.1, 3C7.1, 3C8.1, 3C9.1, 3C10.1, 3C11.1, 3C12.1, 3C13.1, 3C14.1, 3C15.1, 3C16.1, 3C17.1, 3C18.1, 3C19.1, 3C20.1, 3C21.1, 3C22.1, 3C23.1, 3C24.1, 3U1.VS, 3U2.VS, 3U3.VS, 3U4.VS, 3U5.VS, 3U6.VS, 3U7.VS, 3U8.VS, 3U9.VS, 3U10.VS, 3U11.VS, 3U12.VS, 3U13.VS, 3U14.VS, 3U15.VS, 3U16.VS, 3U17.VS, 3U18.VS, 3U19.VS, 3U20.VS, 3U21.VS, 3U22.VS, 3U23.VS, 3U24.VS; also elsewhere on the board
GND: 3C1.2, 3C2.2, 3C3.2, 3C4.2, 3C5.2, 3C6.2, 3C7.2, 3C8.2, 3C9.2, 3C10.2, 3C11.2, 3C12.2, 3C13.2, 3C14.2, 3C15.2, 3C16.2, 3C17.2, 3C18.2, 3C19.2, 3C20.2, 3C21.2, 3C22.2, 3C23.2, 3C24.2, 3U1.GND, 3U2.GND, 3U3.GND, 3U4.GND, 3U5.GND, 3U6.GND, 3U7.GND, 3U8.GND, 3U9.GND, 3U10.GND, 3U11.GND, 3U12.GND, 3U13.GND, 3U14.GND, 3U15.GND, 3U16.GND, 3U17.GND, 3U18.GND, 3U19.GND, 3U20.GND, 3U21.GND, 3U22.GND, 3U23.GND, 3U24.GND; also elsewhere on the board
IR1: 3U1.OUT; also elsewhere on the board
IR2: 3U2.OUT; also elsewhere on the board
IR3: 3U3.OUT; also elsewhere on the board
IR4: 3U4.OUT; also elsewhere on the board
IR5: 3U5.OUT; also elsewhere on the board
IR6: 3U6.OUT; also elsewhere on the board
IR7: 3U7.OUT; also elsewhere on the board
IR8: 3U8.OUT; also elsewhere on the board
IR9: 3U9.OUT; also elsewhere on the board
IR10: 3U10.OUT; also elsewhere on the board
IR11: 3U11.OUT; also elsewhere on the board
IR12: 3U12.OUT; also elsewhere on the board
IR13: 3U13.OUT; also elsewhere on the board
IR14: 3U14.OUT; also elsewhere on the board
IR15: 3U15.OUT; also elsewhere on the board
IR16: 3U16.OUT; also elsewhere on the board
IR17: 3U17.OUT; also elsewhere on the board
IR18: 3U18.OUT; also elsewhere on the board
IR19: 3U19.OUT; also elsewhere on the board
IR20: 3U20.OUT; also elsewhere on the board
IR21: 3U21.OUT; also elsewhere on the board
IR22: 3U22.OUT; also elsewhere on the board
IR23: 3U23.OUT; also elsewhere on the board
IR24: 3U24.OUT; also elsewhere on the board

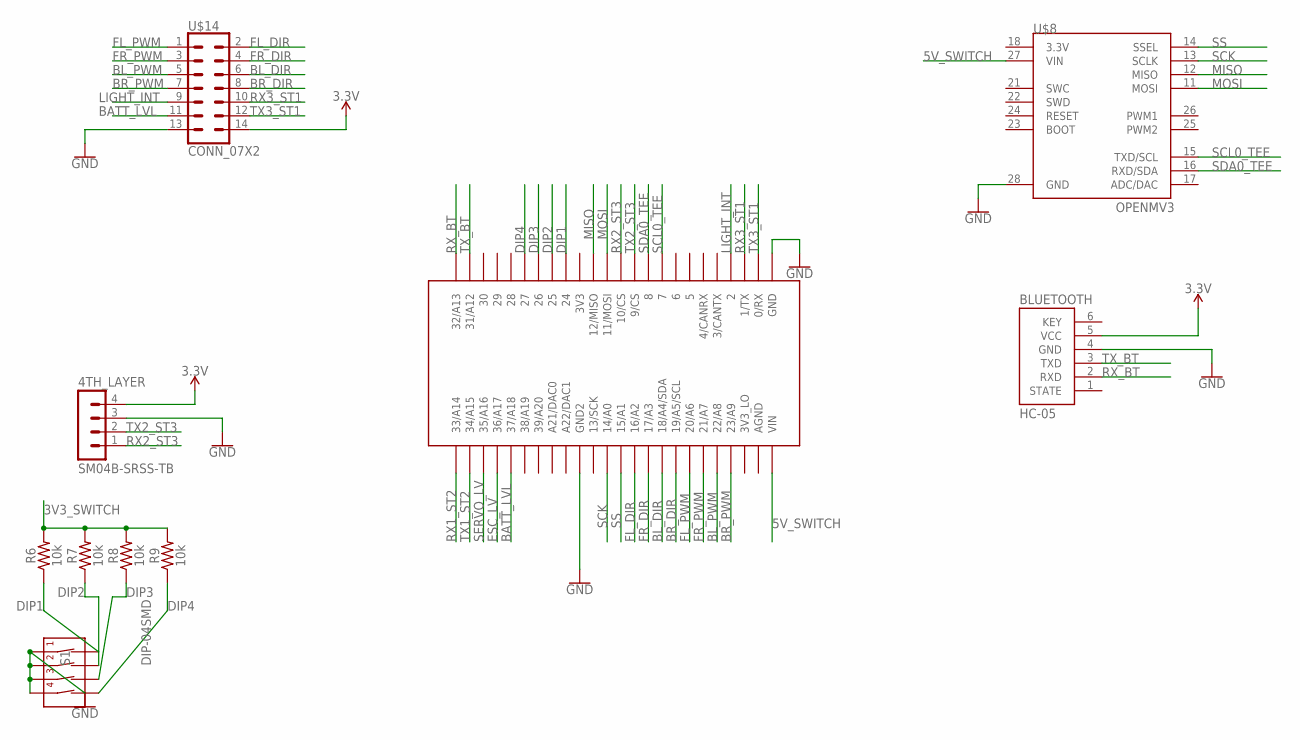
[picture p4: schematic Layer 3.sch, sheet 4]

Parts:
4TH_LAYER: SM04B-SRSS-TB
BLUETOOTH: HC-05
R6, R7, R8, R9: 10k; R0603
S1: DIP-04SMD; DIPSWITCH-04-SMD
U$1: TEENSY_3.5/3.6_NO_MIDDLE
U$8: OPENMV3
U$14: CONN_07X2; 2X7

Connections:
3.3V: 4TH_LAYER.4, BLUETOOTH.5 (VCC), U$14.14; also elsewhere on the board
3V3_SWITCH: R6.2, R7.2, R8.2, R9.2; also elsewhere on the board
5V_SWITCH: U$1.VIN, U$8.27 (VIN); also elsewhere on the board
BATT_LVL: U$1.37/A18, U$14.11
BL_DIR: U$1.18/A4/SDA, U$14.6
BL_PWM: U$1.22/A8, U$14.5
BR_DIR: U$1.19/A5/SCL, U$14.8
BR_PWM: U$1.23/A9, U$14.7
DIP1: R6.1, S1.1 (1A), U$1.24
DIP2: R7.1, S1.2 (2A), U$1.25
DIP3: R8.1, S1.3 (3A), U$1.26
DIP4: R9.1, S1.4 (4A), U$1.27
ESC_LV: U$1.36/A17; also elsewhere on the board
FL_DIR: U$1.16/A2, U$14.2
FL_PWM: U$1.20/A6, U$14.1
FR_DIR: U$1.17/A3, U$14.4
FR_PWM: U$1.21/A7, U$14.3
GND: 4TH_LAYER.3, BLUETOOTH.4 (GND), S1.5 (4B), S1.6 (3B), S1.7 (2B), S1.8 (1B), U$1.GND2, U$8.28 (GND), U$14.13; also elsewhere on the board
LIGHT_INT: U$1.2, U$14.9
MISO: U$1.12/MISO, U$8.12 (MISO)
MOSI: U$1.11/MOSI, U$8.11 (MOSI)
RX1_ST2: U$1.33/A14; also elsewhere on the board
RX2_ST3: 4TH_LAYER.1, U$1.10/CS
RX3_ST1: U$1.1/TX, U$14.10
RX_BT: BLUETOOTH.2 (RXD), U$1.32/A13
SCK: U$1.14/A0, U$8.13 (SCLK)
SCL0_TEE: U$1.7, U$8.15 (TXD/SCL)
SDA0_TEE: U$1.8, U$8.16 (RXD/SDA)
SERVO_LV: U$1.35/A16; also elsewhere on the board
SS: U$1.15/A1, U$8.14 (SSEL)
TX1_ST2: U$1.34/A15; also elsewhere on the board
TX2_ST3: 4TH_LAYER.2, U$1.9/CS
TX3_ST1: U$1.0/RX, U$14.12
TX_BT: BLUETOOTH.3 (TXD), U$1.31/A12

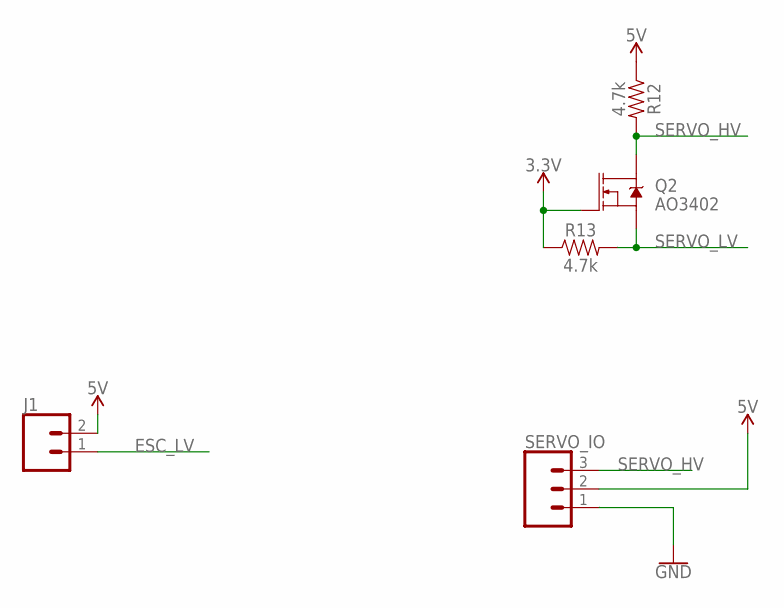
[picture p5: schematic Layer 3.sch, sheet 5, ESC + Servo]

Parts:
J1: CONN_02LOCK; 1X02_LOCK
Q2: AO3402; SOT23-3
R12, R13: 4.7k; R0603
SERVO_IO: CONN_03LOCK; 1X03_LOCK

Connections:
3.3V: Q2.1 (G), R13.1; also elsewhere on the board
5V: J1.2, R12.1, SERVO_IO.2; also elsewhere on the board
ESC_LV: J1.1; also elsewhere on the board
GND: SERVO_IO.1; also elsewhere on the board
SERVO_HV: Q2.3 (D), R12.2, SERVO_IO.3
SERVO_LV: Q2.2 (S), R13.2; also elsewhere on the board

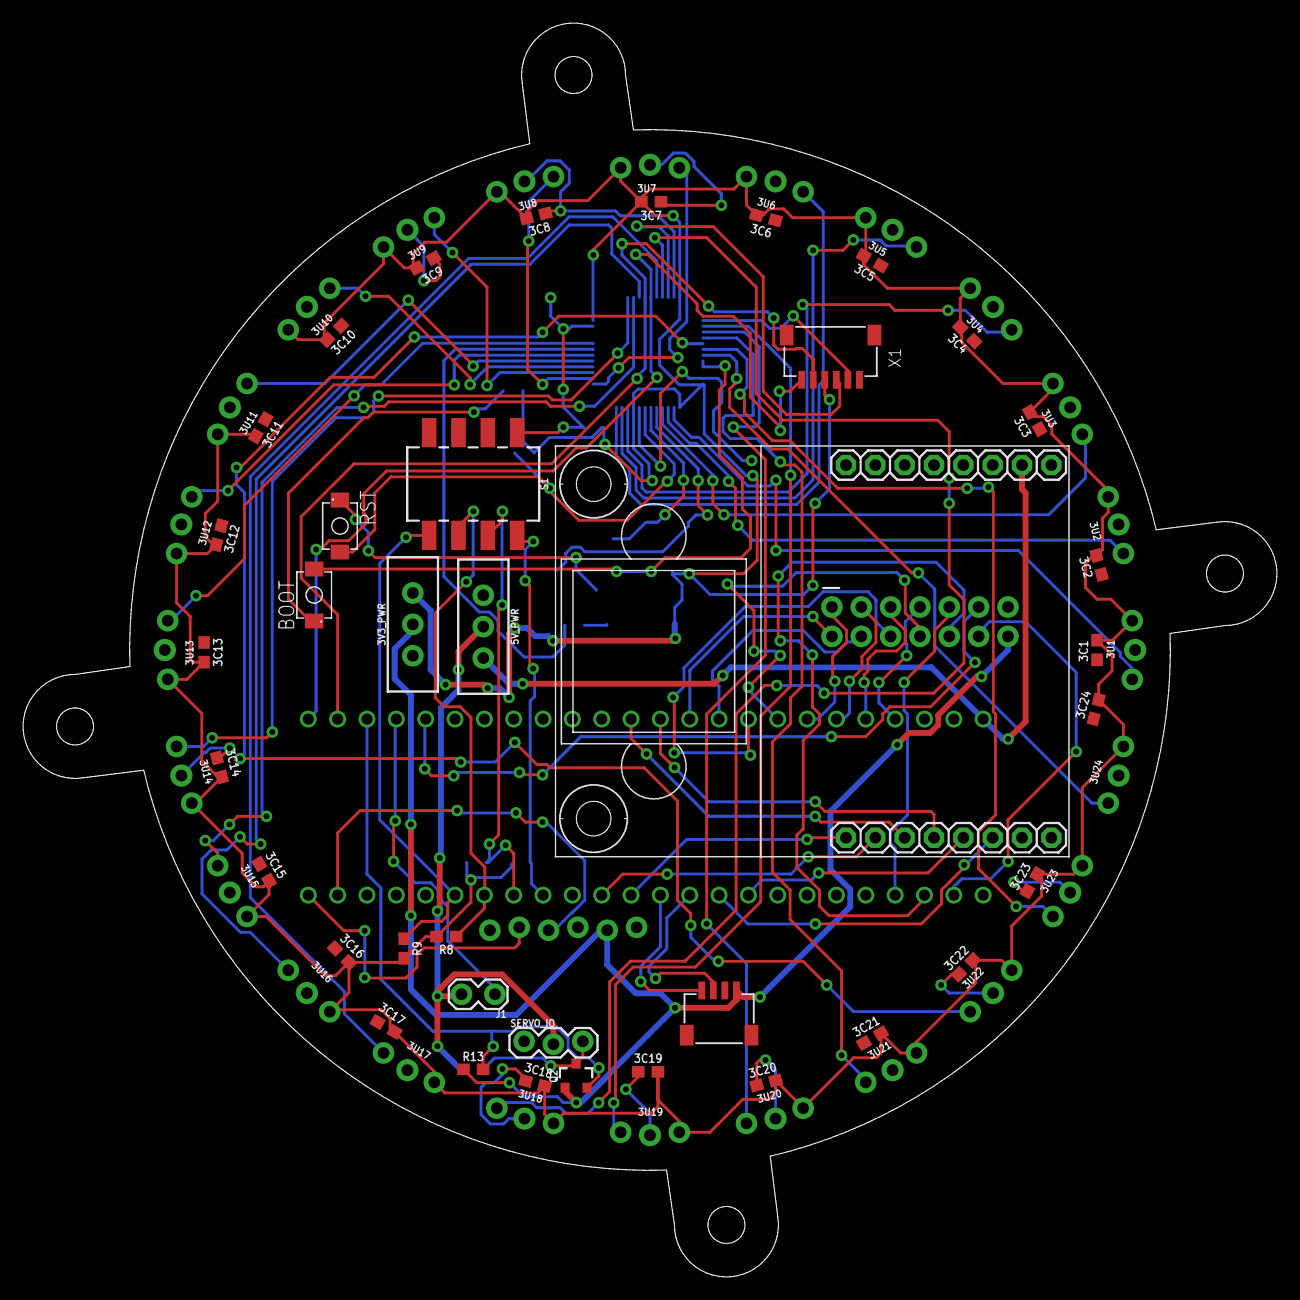
[picture p6: board Layer 3.brd from above]

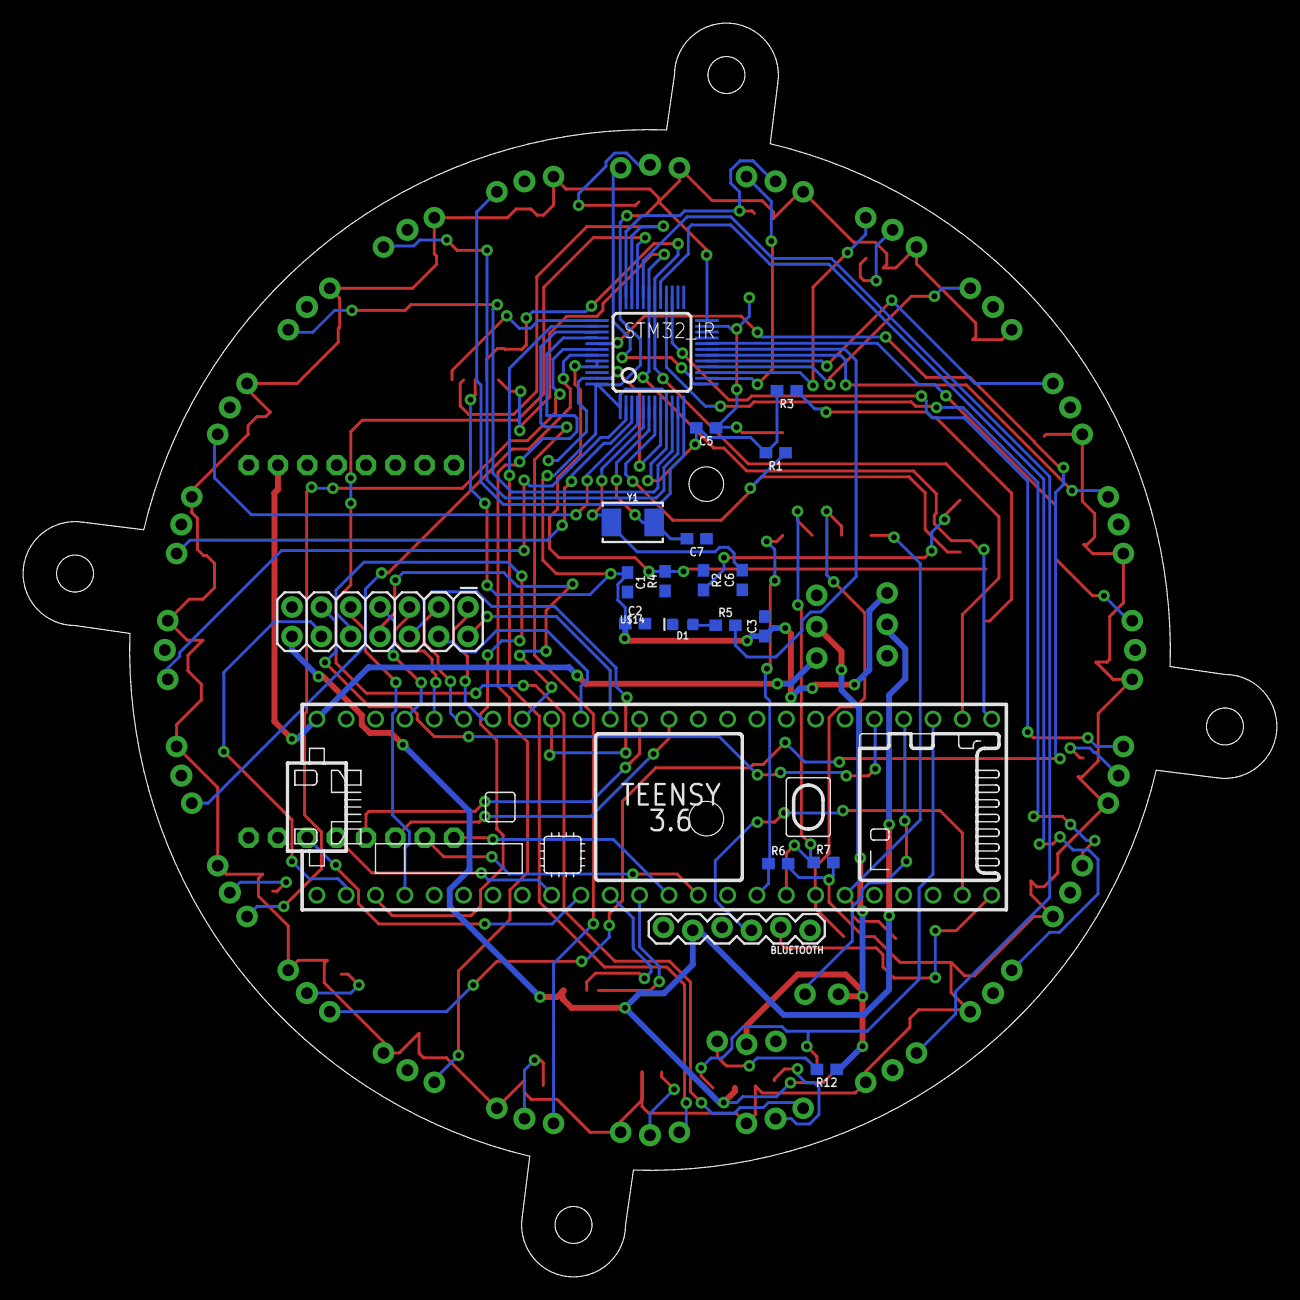
[picture p7: board Layer 3.brd from below]

Board: 2 copper layers, 108.5 x 108.5 mm, 82 parts (20 on the bottom side), 70 nets.
