Team-UwU-Robotics/Team-UwU/Eagle PCB/Layer 4.brd

## EAGLE design Eagle PCB/Layer 4.brd (2021-03-01)

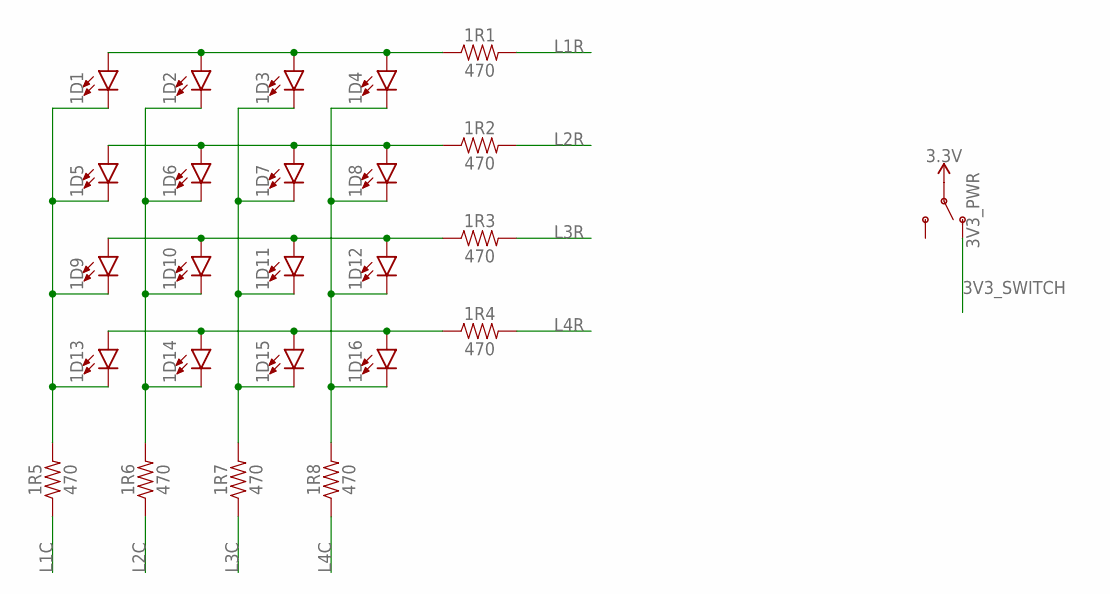
[picture p8: schematic Layer 4.sch, sheet 1, Light Sensor]

Parts:
1D1, 1D2, 1D3, 1D4, 1D5, 1D6, 1D7, 1D8, 1D9, 1D10, 1D11, 1D12, 1D13, 1D14, 1D15, 1D16: LED0603; LED-0603
1R1, 1R2, 1R3, 1R4, 1R5, 1R6, 1R7, 1R8: 470; R0603
3V3_PWR: SWITCH-SPDT-PTH-11.6X4.0MM-LOCK; SWITCH_SPDT_PTH_11.6X4.0MM_LOCK

Connections:
3.3V: 3V3_PWR.2; also elsewhere on the board
3V3_SWITCH: 3V3_PWR.1 (O); also elsewhere on the board
L1C: 1R5.1; also elsewhere on the board
L1R: 1R1.2; also elsewhere on the board
L2C: 1R6.1; also elsewhere on the board
L2R: 1R2.2; also elsewhere on the board
L3C: 1R7.1; also elsewhere on the board
L3R: 1R3.2; also elsewhere on the board
L4C: 1R8.1; also elsewhere on the board
L4R: 1R4.2; also elsewhere on the board
unnamed: 1D1.A, 1D2.A, 1D3.A, 1D4.A, 1R1.1
unnamed: 1D1.C, 1D5.C, 1D9.C, 1D13.C, 1R5.2
unnamed: 1D5.A, 1D6.A, 1D7.A, 1D8.A, 1R2.1
unnamed: 1D9.A, 1D10.A, 1D11.A, 1D12.A, 1R3.1
unnamed: 1D13.A, 1D14.A, 1D15.A, 1D16.A, 1R4.1
unnamed: 1D2.C, 1D6.C, 1D10.C, 1D14.C, 1R6.2
unnamed: 1D3.C, 1D7.C, 1D11.C, 1D15.C, 1R7.2
unnamed: 1D4.C, 1D8.C, 1D12.C, 1D16.C, 1R8.2

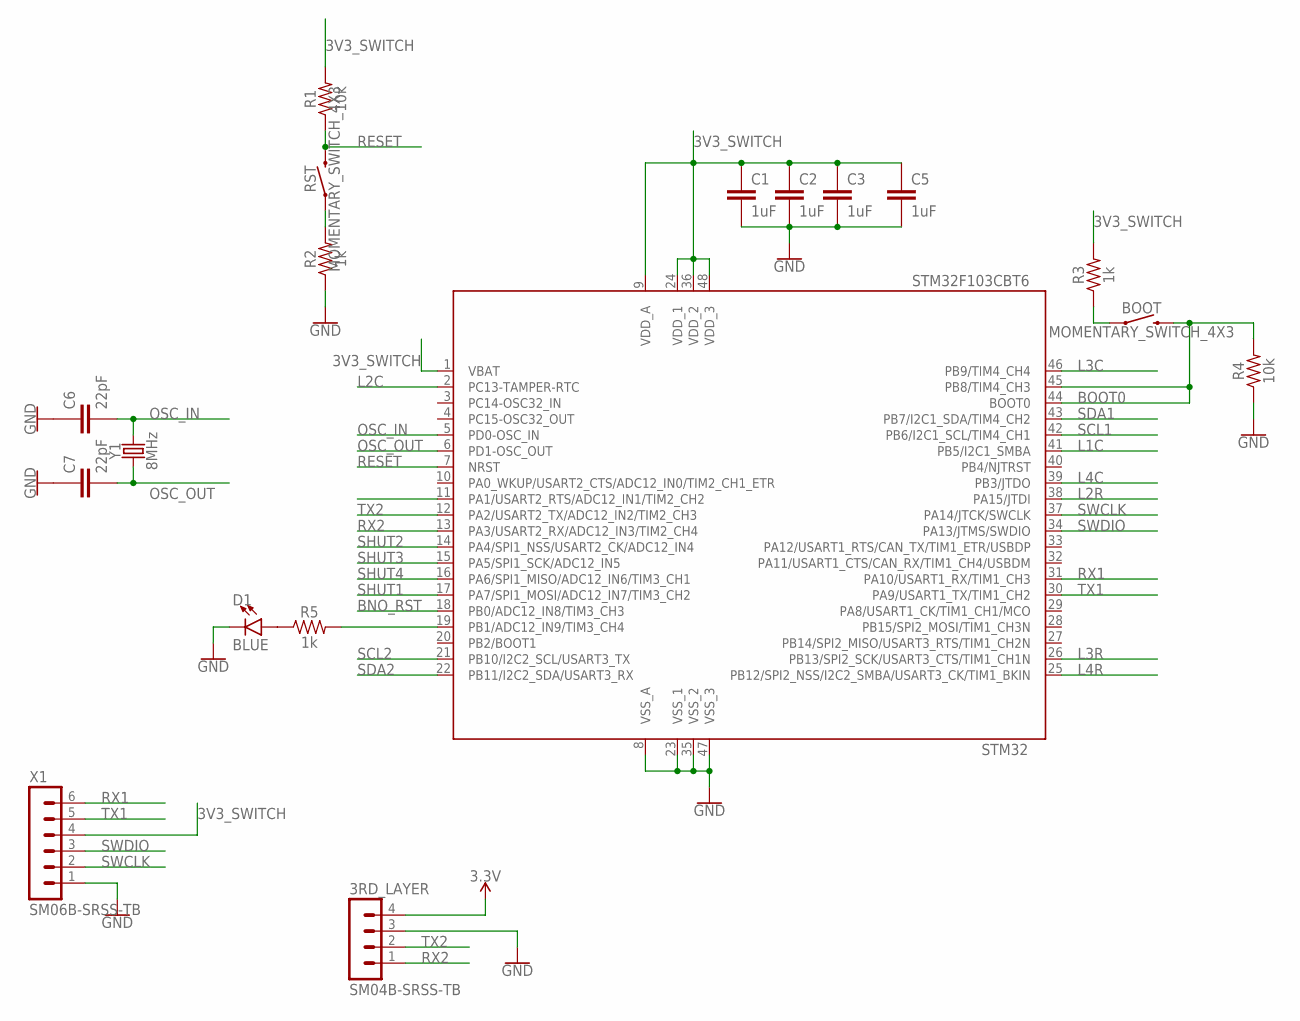
[picture p9: schematic Layer 4.sch, sheet 2, STEM32]

Parts:
3RD_LAYER: SM04B-SRSS-TB
BOOT: MOMENTARY_SWITCH_4X3
C1, C2, C3, C5: 1uF; C0603
C6, C7: 22pF; C0603
D1: BLUE; LED-0603
R1, R4: 10k; R0603
R2, R3, R5: 1k; R0603
RST: MOMENTARY_SWITCH_4X3
STM32: STM32F103CBT6; LQFP48
X1: SM06B-SRSS-TB
Y1: 8MHz; CRYSTAL-SMD-5X3.2-2PAD

Connections:
3.3V: 3RD_LAYER.4; also elsewhere on the board
3V3_SWITCH: C1.1, C2.1, C3.1, C5.2, R1.2, R3.2, STM32.1 (VBAT), STM32.9 (VDD_A), STM32.24 (VDD_1), STM32.36 (VDD_2), STM32.48 (VDD_3), X1.4; also elsewhere on the board
BNO_RST: STM32.18 (PB0/ADC12_IN8/TIM3_CH3); also elsewhere on the board
BOOT0: BOOT.P$2 (2), R4.2, STM32.44 (BOOT0), STM32.45 (PB8/TIM4_CH3)
GND: 3RD_LAYER.3, C1.2, C2.2, C3.2, C5.1, C6.1, C7.1, D1.C, R2.1, R4.1, STM32.8 (VSS_A), STM32.23 (VSS_1), STM32.35 (VSS_2), STM32.47 (VSS_3), X1.1; also elsewhere on the board
L1C: STM32.41 (PB5/I2C1_SMBA); also elsewhere on the board
L1R: STM32.11 (PA1/USART2_RTS/ADC12_IN1/TIM2_CH2); also elsewhere on the board
L2C: STM32.2 (PC13-TAMPER-RTC); also elsewhere on the board
L2R: STM32.38 (PA15/JTDI); also elsewhere on the board
L3C: STM32.46 (PB9/TIM4_CH4); also elsewhere on the board
L3R: STM32.26 (PB13/SPI2_SCK/USART3_CTS/TIM1_CH1N); also elsewhere on the board
L4C: STM32.39 (PB3/JTDO); also elsewhere on the board
L4R: STM32.25 (PB12/SPI2_NSS/I2C2_SMBA/USART3_CK/TIM1_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); also elsewhere on the board
unnamed: R2.2, RST.P$1 (1)
unnamed: BOOT.P$1 (1), R3.1
unnamed: R5.2, STM32.19 (PB1/ADC12_IN9/TIM3_CH4)
unnamed: D1.A, R5.1
OSC_IN: C6.2, STM32.5 (PD0-OSC_IN), Y1.P$2 (2)
OSC_OUT: C7.2, STM32.6 (PD1-OSC_OUT), Y1.P$1 (1)
RESET: R1.1, RST.P$2 (2), STM32.7 (NRST)
RX1: STM32.31 (PA10/USART1_RX/TIM1_CH3), X1.6
RX2: 3RD_LAYER.1, STM32.13 (PA3/USART2_RX/ADC12_IN3/TIM2_CH4)
SCL1: STM32.42 (PB6/I2C1_SCL/TIM4_CH1); also elsewhere on the board
SCL2: STM32.21 (PB10/I2C2_SCL/USART3_TX); also elsewhere on the board
SDA1: STM32.43 (PB7/I2C1_SDA/TIM4_CH2); also elsewhere on the board
SDA2: STM32.22 (PB11/I2C2_SDA/USART3_RX); also elsewhere on the board
SHUT1: STM32.17 (PA7/SPI1_MOSI/ADC12_IN7/TIM3_CH2); also elsewhere on the board
SHUT2: STM32.14 (PA4/SPI1_NSS/USART2_CK/ADC12_IN4); also elsewhere on the board
SHUT3: STM32.15 (PA5/SPI1_SCK/ADC12_IN5); also elsewhere on the board
SHUT4: STM32.16 (PA6/SPI1_MISO/ADC12_IN6/TIM3_CH1); also elsewhere on the board
SWCLK: STM32.37 (PA14/JTCK/SWCLK), X1.2
SWDIO: STM32.34 (PA13/JTMS/SWDIO), X1.3
TX1: STM32.30 (PA9/USART1_TX/TIM1_CH2), X1.5
TX2: 3RD_LAYER.2, STM32.12 (PA2/USART2_TX/ADC12_IN2/TIM2_CH3)

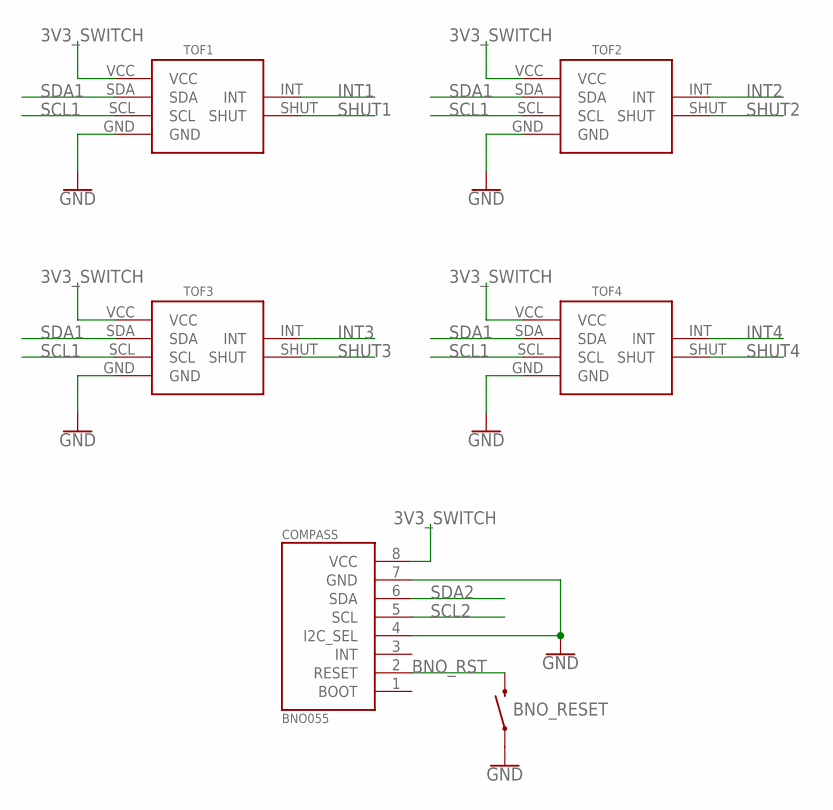
[picture p10: schematic Layer 4.sch, sheet 3, Sensors]

Parts:
BNO_RESET: MOMENTARY_SWITCH_4X3
COMPASS: BNO055
TOF1, TOF2, TOF3, TOF4: VL53L1X; VL53L1X_SLANTEDPINS

Connections:
3V3_SWITCH: COMPASS.8 (VCC), TOF1.VCC, TOF2.VCC, TOF3.VCC, TOF4.VCC; also elsewhere on the board
BNO_RST: BNO_RESET.P$2 (2), COMPASS.2 (RESET); also elsewhere on the board
GND: BNO_RESET.P$1 (1), COMPASS.4 (I2C_SEL), COMPASS.7 (GND), TOF1.GND, TOF2.GND, TOF3.GND, TOF4.GND; also elsewhere on the board
INT1: TOF1.INT
INT2: TOF2.INT
INT3: TOF3.INT
INT4: TOF4.INT
SCL1: TOF1.SCL, TOF2.SCL, TOF3.SCL, TOF4.SCL; also elsewhere on the board
SCL2: COMPASS.5 (SCL); also elsewhere on the board
SDA1: TOF1.SDA, TOF2.SDA, TOF3.SDA, TOF4.SDA; also elsewhere on the board
SDA2: COMPASS.6 (SDA); also elsewhere on the board
SHUT1: TOF1.SHUT; also elsewhere on the board
SHUT2: TOF2.SHUT; also elsewhere on the board
SHUT3: TOF3.SHUT; also elsewhere on the board
SHUT4: TOF4.SHUT; also elsewhere on the board

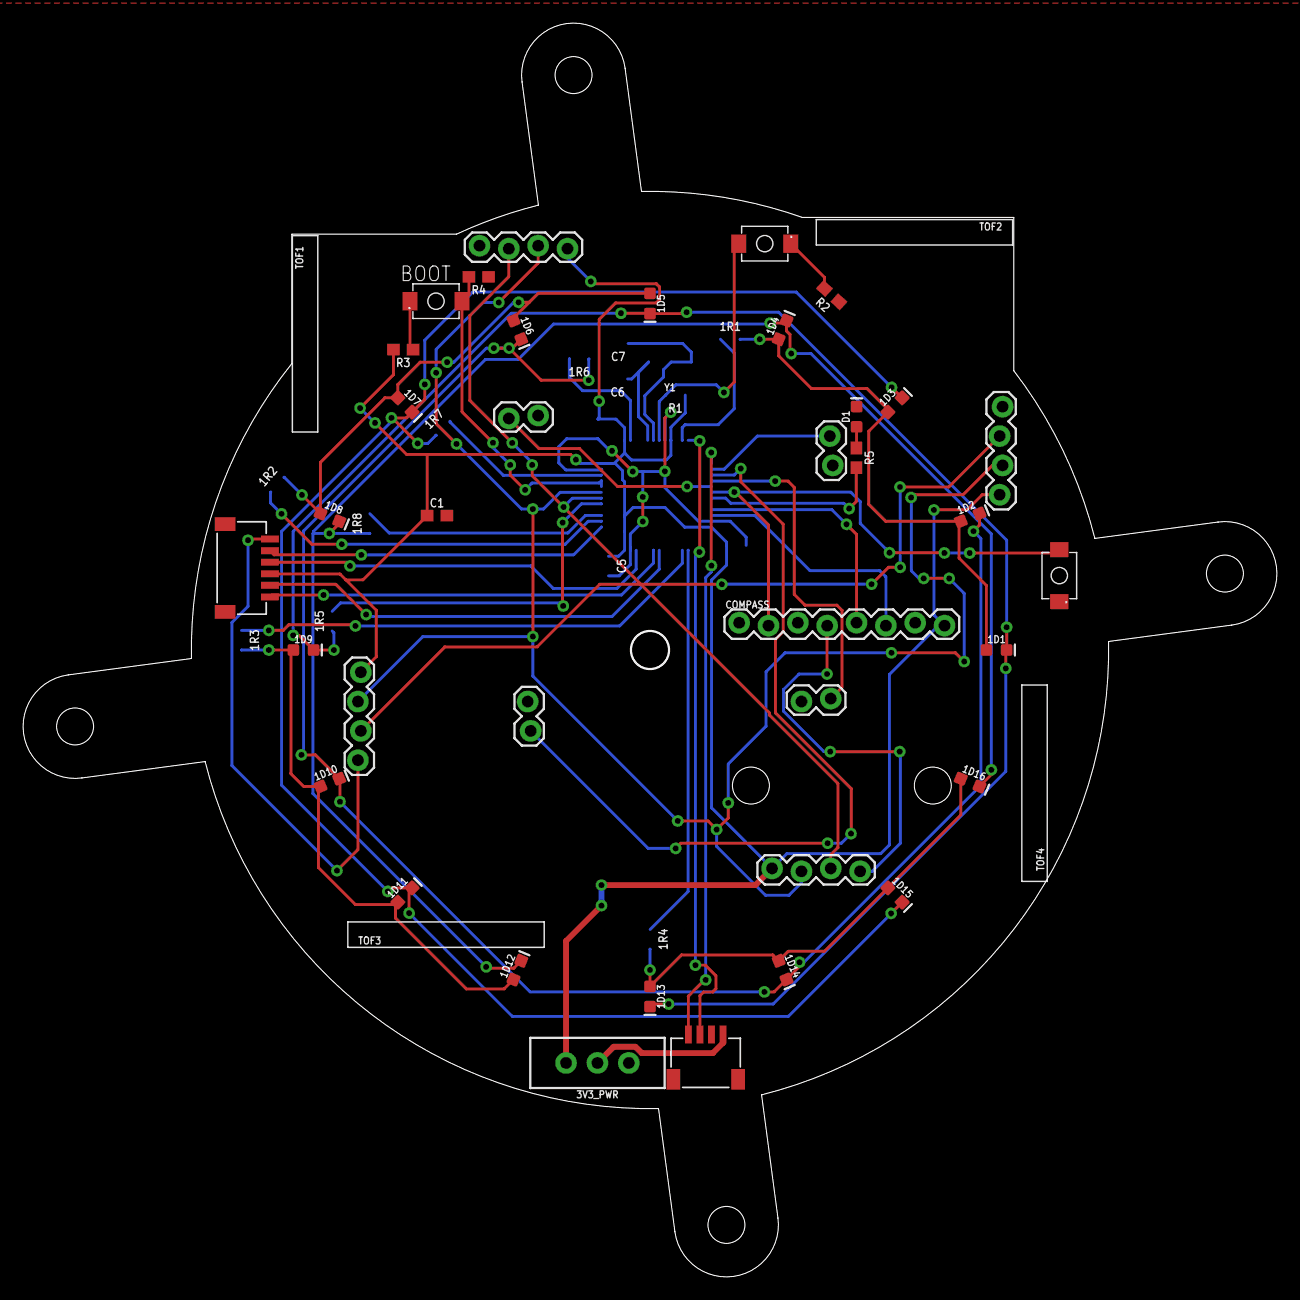
[picture p11: board Layer 4.brd from above]

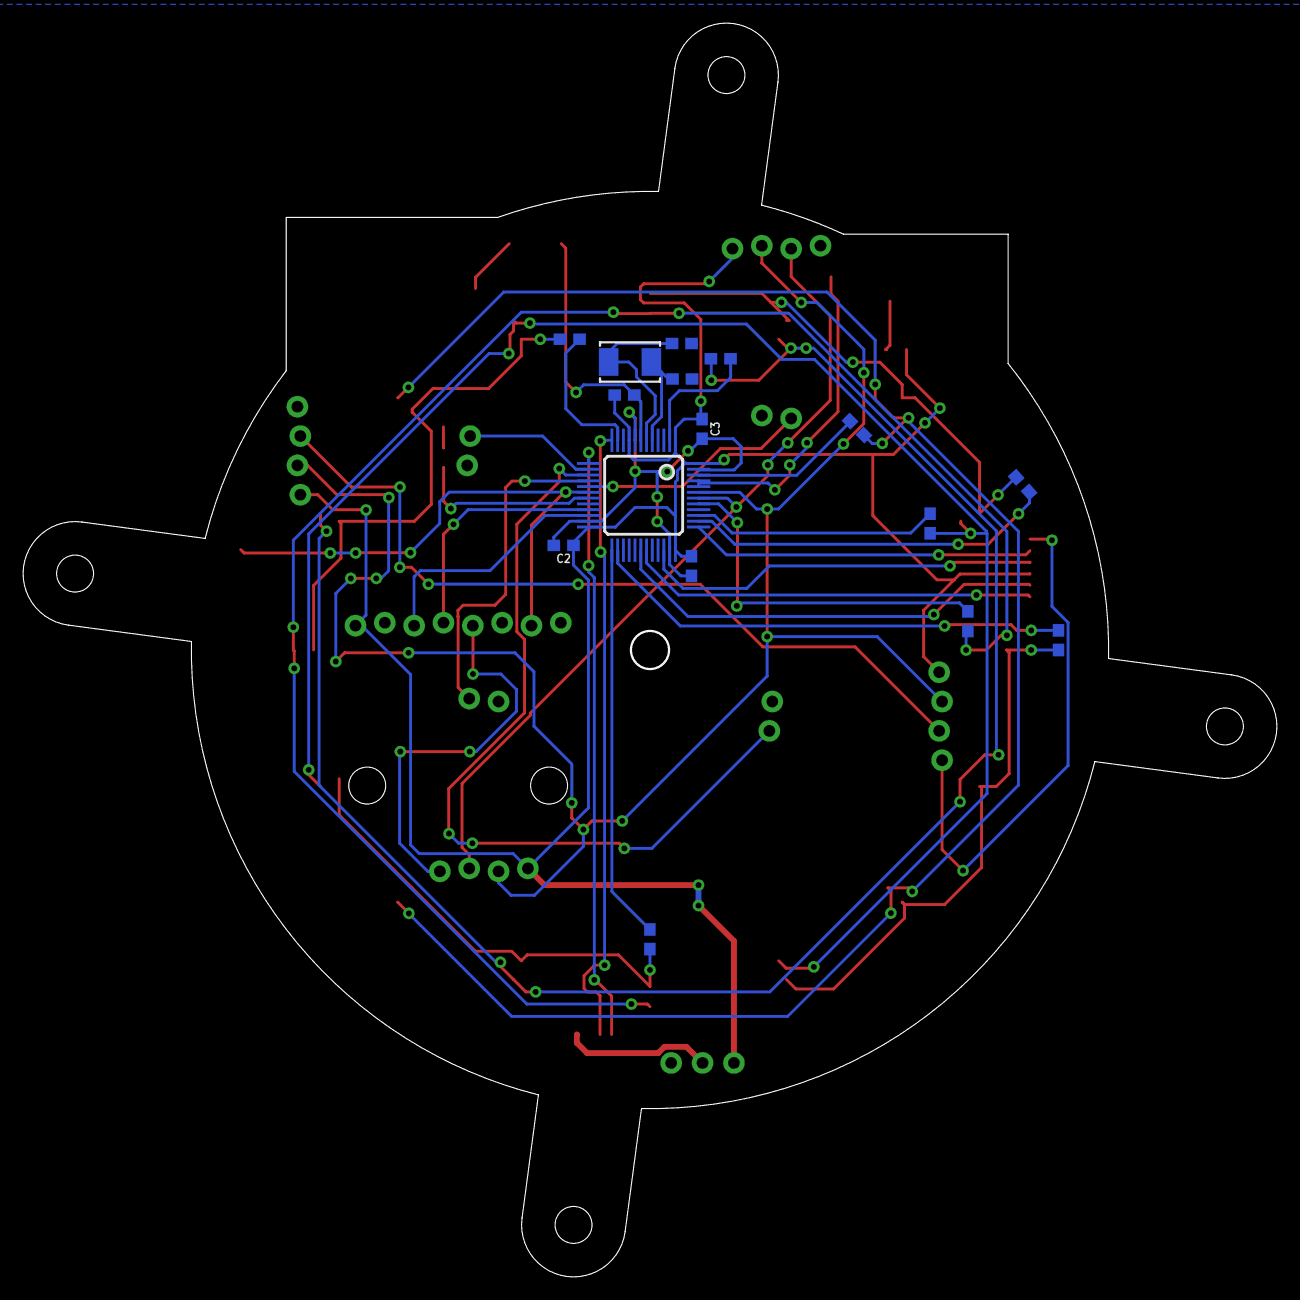
[picture p12: board Layer 4.brd from below]

Board: 2 copper layers, 108.5 x 108.5 mm, 49 parts (16 on the bottom side), 42 nets.
