Team-UwU-Robotics/Team-UwU/Eagle PCB/Layer 1.brd

## EAGLE design Eagle PCB/Layer 1.brd (2021-03-01)

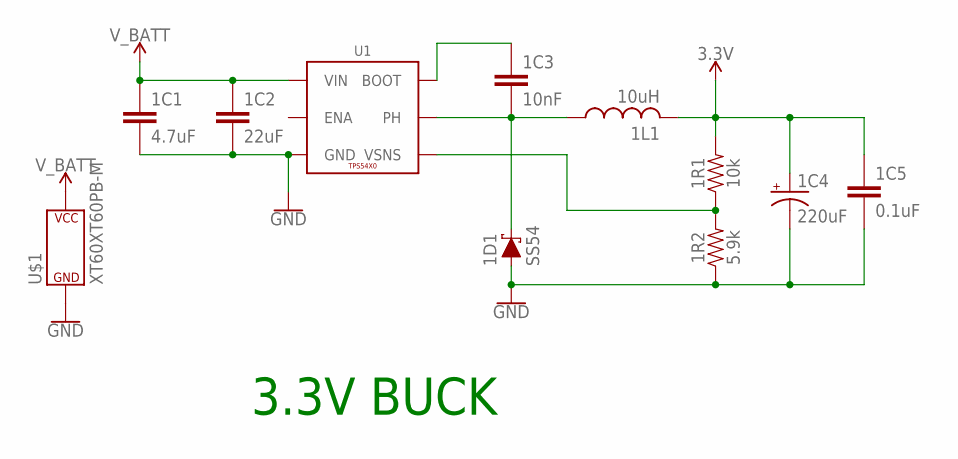
[picture p13: schematic Layer 1.sch, sheet 1]

Parts:
1C1: 4.7uF; C0603
1C2: 22uF; C1210
1C3: 10nF; C0603
1C4: 220uF; EIA7343
1C5: 0.1uF; C0603
1D1: SS54; SMA-DIODE
1L1: 10uH; SWPA8040
1R1: 10k; R0603
1R2: 5.9k; R0603
U1: TPS54X0; POWERPAD-SOIC-8
U$1: XT60XT60PB-M; XT60PB-M

Connections:
3.3V: 1C4.A (+), 1C5.1, 1L1.P2 (2), 1R1.2; also elsewhere on the board
GND: 1C1.2, 1C2.2, 1C4.C (-), 1C5.2, 1D1.A, 1R2.1, U1.6 (GND), U1.9 (GND), U1.P$1 (GND), U1.P$2 (GND), U1.P$3 (GND), U1.P$4 (GND), U1.P$5 (GND), U1.P$6 (GND), U$1.- (P$V-); also elsewhere on the board
unnamed: 1C3.1, U1.1 (BOOT)
unnamed: 1C3.2, 1D1.C, 1L1.P1 (1), U1.8 (PH)
unnamed: 1R1.1, 1R2.2, U1.4 (VSNS)
V_BATT: 1C1.1, 1C2.1, U1.7 (VIN), U$1.+ (P$V+); also elsewhere on the board

Notes on the sheet:
3.3V BUCK
