Team-UwU-Robotics/Team-UwU/Eagle PCB/Layer 1.brd

## EAGLE design Eagle PCB/Layer 1.brd (continued)

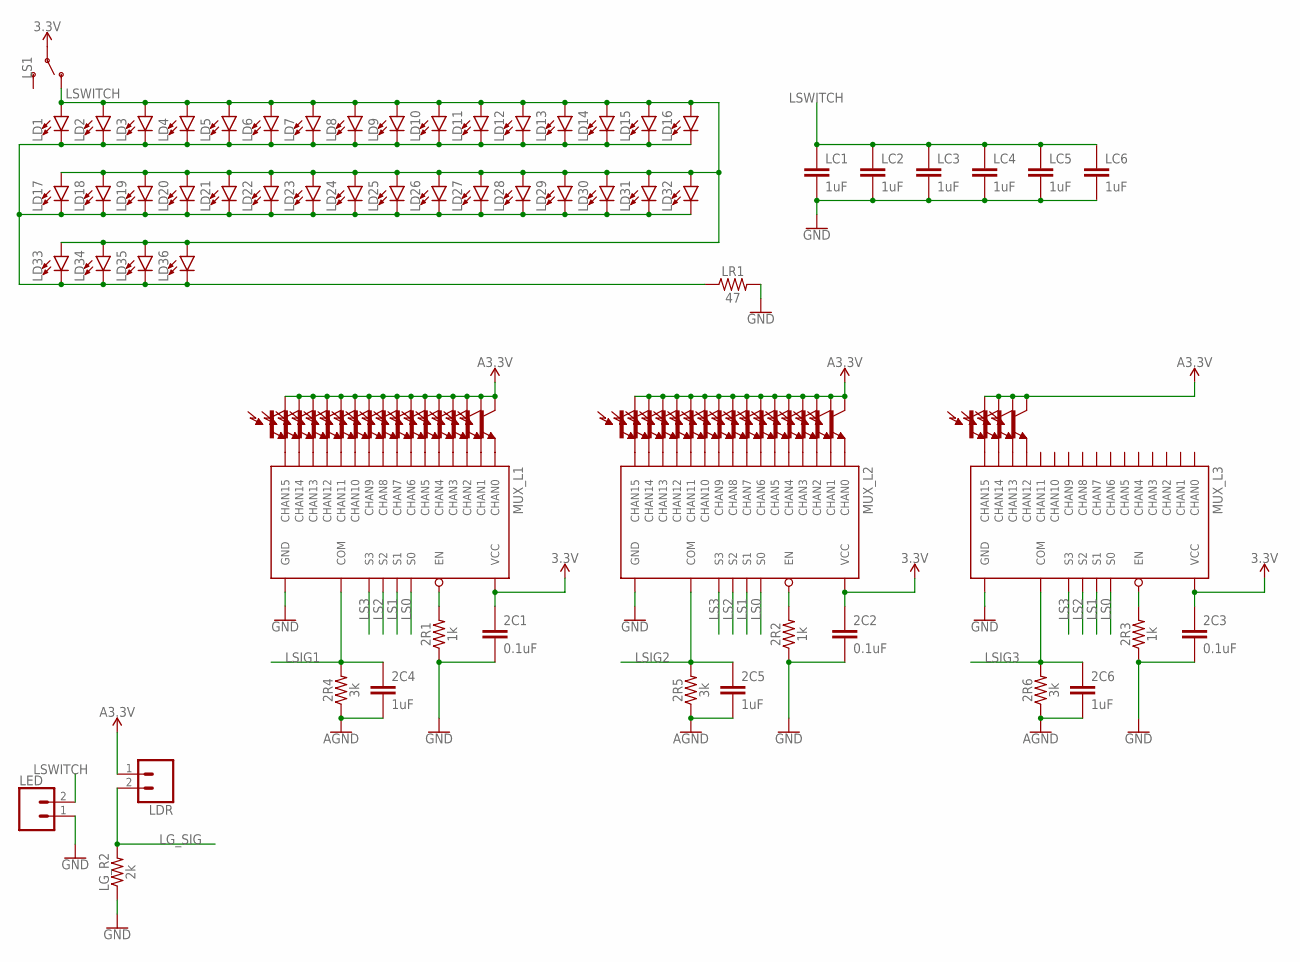
[picture p14: schematic Layer 1.sch, sheet 2]

Parts:
2C1, 2C2, 2C3: 0.1uF; C0603
2C4, 2C5, 2C6: 1uF; C0603
2R1, 2R2, 2R3: 1k; R0603
2R4, 2R5, 2R6: 3k; R0603
LC1, LC2, LC3, LC4, LC5, LC6: 1uF; C0603
LD1, LD2, LD3, LD4, LD5, LD6, LD7, LD8, LD9, LD10, LD11, LD12, LD13, LD14, LD15, LD16, LD17, LD18, LD19, LD20, LD21, LD22, LD23, LD24, LD25, LD26, LD27, LD28, LD29, LD30, LD31, LD32, LD33, LD34, LD35, LD36: 3528LED; 3528
LDR: CONN_021X02_NO_SILK; 1X02_NO_SILK
LED: CONN_02POLAR; MOLEX-1X2
LG_R2: 2k; R0603
LR1: 47; R0603
LS1: SWITCH-SPDT-PTH-11.6X4.0MM-LOCK; SWITCH_SPDT_PTH_11.6X4.0MM_LOCK
MUX_L1, MUX_L2, MUX_L3: 74HC4067SSOP-24; SSOP24
Q1, Q2, Q3, Q4, Q5, Q6, Q7, Q8, Q9, Q10, Q11, Q12, Q13, Q14, Q15, Q16, Q17, Q18, Q19, Q20, Q21, Q22, Q23, Q24, Q25, Q26, Q27, Q28, Q29, Q30, Q31, Q32, Q33, Q34, Q35, Q36: LIGHT_SENSORALS; ALS-PT19

Connections:
3.3V: 2C1.1, 2C2.1, 2C3.1, LS1.2, MUX_L1.24 (VCC), MUX_L2.24 (VCC), MUX_L3.24 (VCC); also elsewhere on the board
AGND: 2C4.2, 2C5.2, 2C6.2, 2R4.1, 2R5.1, 2R6.1; also elsewhere on the board
GND: 2C1.2, 2C2.2, 2C3.2, 2R1.1, 2R2.1, 2R3.1, LC1.2, LC2.2, LC3.2, LC4.2, LC5.2, LC6.2, LED.1, LG_R2.1, LR1.2, MUX_L1.12 (GND), MUX_L2.12 (GND), MUX_L3.12 (GND); also elsewhere on the board
LG_SIG: LDR.2, LG_R2.2; also elsewhere on the board
LS0: MUX_L1.10 (S0), MUX_L2.10 (S0), MUX_L3.10 (S0); also elsewhere on the board
LS1: MUX_L1.11 (S1), MUX_L2.11 (S1), MUX_L3.11 (S1); also elsewhere on the board
LS2: MUX_L1.14 (S2), MUX_L2.14 (S2), MUX_L3.14 (S2); also elsewhere on the board
LS3: MUX_L1.13 (S3), MUX_L2.13 (S3), MUX_L3.13 (S3); also elsewhere on the board
LSIG1: 2C4.1, 2R4.2, MUX_L1.1 (COM); also elsewhere on the board
LSIG2: 2C5.1, 2R5.2, MUX_L2.1 (COM); also elsewhere on the board
LSIG3: 2C6.1, 2R6.2, MUX_L3.1 (COM); also elsewhere on the board
LSWITCH: LC1.1, LC2.1, LC3.1, LC4.1, LC5.1, LC6.1, LD1.A, LD2.A, LD3.A, LD4.A, LD5.A, LD6.A, LD7.A, LD8.A, LD9.A, LD10.A, LD11.A, LD12.A, LD13.A, LD14.A, LD15.A, LD16.A, LD17.A, LD18.A, LD19.A, LD20.A, LD21.A, LD22.A, LD23.A, LD24.A, LD25.A, LD26.A, LD27.A, LD28.A, LD29.A, LD30.A, LD31.A, LD32.A, LD33.A, LD34.A, LD35.A, LD36.A, LED.2, LS1.1 (O)
unnamed: 2R1.2, MUX_L1.15 (EN)
unnamed: MUX_L1.16 (CHAN15), Q1.E (E1)
unnamed: MUX_L1.17 (CHAN14), Q2.E (E1)
unnamed: MUX_L1.18 (CHAN13), Q3.E (E1)
unnamed: MUX_L1.19 (CHAN12), Q4.E (E1)
unnamed: MUX_L1.20 (CHAN11), Q5.E (E1)
unnamed: MUX_L1.21 (CHAN10), Q6.E (E1)
unnamed: MUX_L1.22 (CHAN9), Q7.E (E1)
unnamed: MUX_L1.23 (CHAN8), Q8.E (E1)
unnamed: MUX_L1.2 (CHAN7), Q9.E (E1)
unnamed: MUX_L1.3 (CHAN6), Q10.E (E1)
unnamed: MUX_L1.4 (CHAN5), Q11.E (E1)
unnamed: MUX_L1.5 (CHAN4), Q12.E (E1)
unnamed: MUX_L1.6 (CHAN3), Q13.E (E1)
unnamed: MUX_L1.7 (CHAN2), Q14.E (E1)
unnamed: MUX_L1.8 (CHAN1), Q15.E (E1)
unnamed: MUX_L1.9 (CHAN0), Q16.E (E1)
unnamed: LD1.C, LD2.C, LD3.C, LD4.C, LD5.C, LD6.C, LD7.C, LD8.C, LD9.C, LD10.C, LD11.C, LD12.C, LD13.C, LD14.C, LD15.C, LD16.C, LD17.C, LD18.C, LD19.C, LD20.C, LD21.C, LD22.C, LD23.C, LD24.C, LD25.C, LD26.C, LD27.C, LD28.C, LD29.C, LD30.C, LD31.C, LD32.C, LD33.C, LD34.C, LD35.C, LD36.C, LR1.1
unnamed: 2R2.2, MUX_L2.15 (EN)
unnamed: MUX_L2.16 (CHAN15), Q17.E (E1)
unnamed: MUX_L2.17 (CHAN14), Q18.E (E1)
unnamed: MUX_L2.18 (CHAN13), Q19.E (E1)
unnamed: MUX_L2.19 (CHAN12), Q20.E (E1)
unnamed: MUX_L2.20 (CHAN11), Q21.E (E1)
unnamed: MUX_L2.21 (CHAN10), Q22.E (E1)
unnamed: MUX_L2.22 (CHAN9), Q23.E (E1)
unnamed: MUX_L2.23 (CHAN8), Q24.E (E1)
unnamed: MUX_L2.2 (CHAN7), Q25.E (E1)
unnamed: MUX_L2.3 (CHAN6), Q26.E (E1)
unnamed: MUX_L2.4 (CHAN5), Q27.E (E1)
unnamed: MUX_L2.5 (CHAN4), Q28.E (E1)
unnamed: MUX_L2.6 (CHAN3), Q29.E (E1)
unnamed: MUX_L2.7 (CHAN2), Q30.E (E1)
unnamed: MUX_L2.8 (CHAN1), Q31.E (E1)
unnamed: MUX_L2.9 (CHAN0), Q32.E (E1)
unnamed: 2R3.2, MUX_L3.15 (EN)
unnamed: MUX_L3.16 (CHAN15), Q33.E (E1)
unnamed: MUX_L3.17 (CHAN14), Q34.E (E1)
unnamed: MUX_L3.18 (CHAN13), Q35.E (E1)
unnamed: MUX_L3.19 (CHAN12), Q36.E (E1)
VCCA: LDR.1, Q1.C (C1), Q2.C (C1), Q3.C (C1), Q4.C (C1), Q5.C (C1), Q6.C (C1), Q7.C (C1), Q8.C (C1), Q9.C (C1), Q10.C (C1), Q11.C (C1), Q12.C (C1), Q13.C (C1), Q14.C (C1), Q15.C (C1), Q16.C (C1), Q17.C (C1), Q18.C (C1), Q19.C (C1), Q20.C (C1), Q21.C (C1), Q22.C (C1), Q23.C (C1), Q24.C (C1), Q25.C (C1), Q26.C (C1), Q27.C (C1), Q28.C (C1), Q29.C (C1), Q30.C (C1), Q31.C (C1), Q32.C (C1), Q33.C (C1), Q34.C (C1), Q35.C (C1), Q36.C (C1); also elsewhere on the board

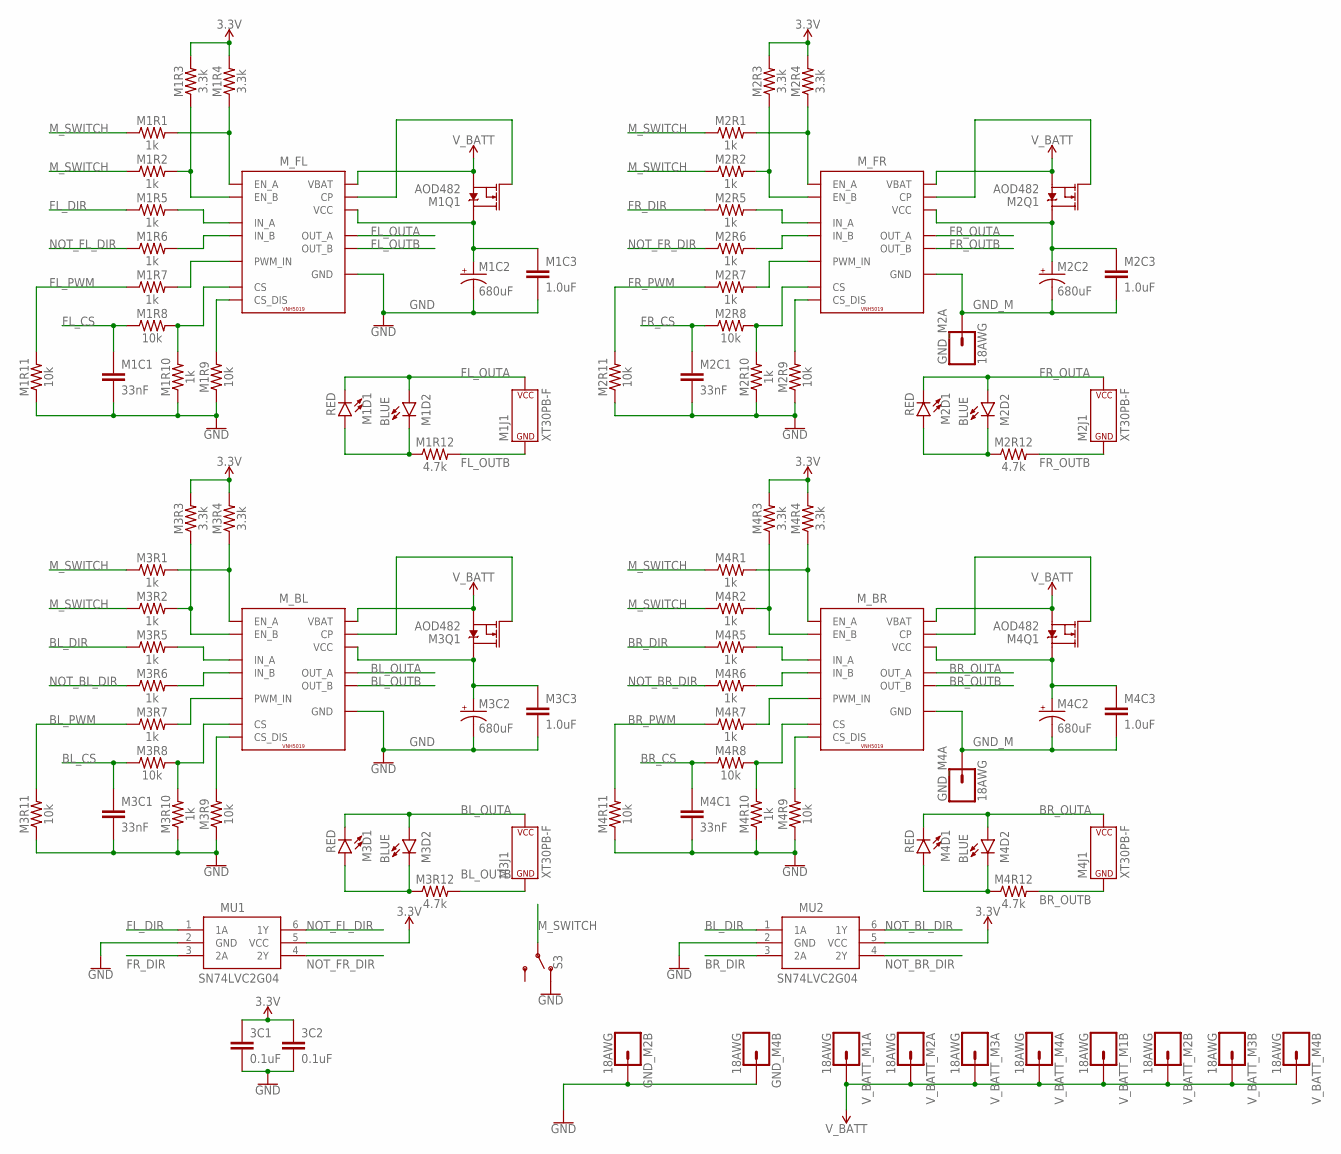
[picture p15: schematic Layer 1.sch, sheet 3]

Parts:
3C1, 3C2: 0.1uF; C0603
GND_M2A, GND_M2B, GND_M4A, GND_M4B: 18AWG
M1C1, M2C1, M3C1, M4C1: 33nF; C0603
M1C2, M2C2, M3C2, M4C2: 680uF; 3.5MM_CAP
M1C3, M2C3, M3C3, M4C3: 1.0uF; C0603
M1D1, M2D1, M3D1, M4D1: RED; LED-0603
M1D2, M2D2, M3D2, M4D2: BLUE; LED-0603
M1J1, M2J1, M3J1, M4J1: XT30PB-F
M1Q1, M2Q1, M3Q1, M4Q1: AOD482; DPAK
M1R1, M1R2, M1R5, M1R6, M1R7, M1R10, M2R1, M2R2, M2R5, M2R6, M2R7, M2R10, M3R1, M3R2, M3R5, M3R6, M3R7, M3R10, M4R1, M4R2, M4R5, M4R6, M4R7, M4R10: 1k; R0603
M1R3, M1R4, M2R3, M2R4, M3R3, M3R4, M4R3, M4R4: 3.3k; R0603
M1R8, M1R9, M1R11, M2R8, M2R9, M2R11, M3R8, M3R9, M3R11, M4R8, M4R9, M4R11: 10k; R0603
M1R12, M2R12, M3R12, M4R12: 4.7k; R0603
MU1, MU2: SN74LVC2G04DBVR; SOT23-6
M_BL: VNH5019; POWERSO-30
M_BR: VNH5019; POWERSO-30
M_FL: VNH5019; POWERSO-30
M_FR: VNH5019; POWERSO-30
S3: SWITCH-SPDT-PTH-11.6X4.0MM-LOCK; SWITCH_SPDT_PTH_11.6X4.0MM_LOCK
V_BATT_M1A, V_BATT_M1B, V_BATT_M2A, V_BATT_M2B, V_BATT_M3A, V_BATT_M3B, V_BATT_M4A, V_BATT_M4B: 18AWG

Connections:
3.3V: 3C1.1, 3C2.1, M1R3.2, M1R4.2, M2R3.2, M2R4.2, M3R3.2, M3R4.2, M4R3.2, M4R4.2, MU1.5 (VCC), MU2.5 (VCC); also elsewhere on the board
BL_CS: M3C1.1, M3R8.1; also elsewhere on the board
BL_DIR: M3R5.1, MU2.1 (1A); also elsewhere on the board
BL_OUTA: M3D1.C, M3D2.A, M3J1.+ (P$V+), M_BL.P1 (OUT_A), M_BL.P25 (OUT_A), M_BL.P30 (OUT_A), M_BL.P$1 (OUT_A), M_BL.P$2 (OUT_A), M_BL.P$3 (OUT_A), M_BL.P$4 (OUT_A), M_BL.P$5 (OUT_A), M_BL.P$6 (OUT_A), M_BL.P$7 (OUT_A), M_BL.P$8 (OUT_A), M_BL.P$9 (OUT_A), M_BL.SLUG2 (OUT_A)
BL_OUTB: M3J1.- (P$V-), M3R12.2, M_BL.P15 (OUT_B), M_BL.P16 (OUT_B), M_BL.P21 (OUT_B), M_BL.P$10 (OUT_B), M_BL.P$11 (OUT_B), M_BL.P$12 (OUT_B), M_BL.P$13 (OUT_B), M_BL.P$14 (OUT_B), M_BL.P$15 (OUT_B), M_BL.P$16 (OUT_B), M_BL.P$17 (OUT_B), M_BL.P$18 (OUT_B), M_BL.SLUG3 (OUT_B)
BL_PWM: M3R7.1, M3R11.2; also elsewhere on the board
BR_CS: M4C1.1, M4R8.1; also elsewhere on the board
BR_DIR: M4R5.1, MU2.3 (2A); also elsewhere on the board
BR_OUTA: M4D1.C, M4D2.A, M4J1.+ (P$V+), M_BR.P1 (OUT_A), M_BR.P25 (OUT_A), M_BR.P30 (OUT_A), M_BR.P$1 (OUT_A), M_BR.P$2 (OUT_A), M_BR.P$3 (OUT_A), M_BR.P$4 (OUT_A), M_BR.P$5 (OUT_A), M_BR.P$6 (OUT_A), M_BR.P$7 (OUT_A), M_BR.P$8 (OUT_A), M_BR.P$9 (OUT_A), M_BR.SLUG2 (OUT_A)
BR_OUTB: M4J1.- (P$V-), M4R12.2, M_BR.P15 (OUT_B), M_BR.P16 (OUT_B), M_BR.P21 (OUT_B), M_BR.P$10 (OUT_B), M_BR.P$11 (OUT_B), M_BR.P$12 (OUT_B), M_BR.P$13 (OUT_B), M_BR.P$14 (OUT_B), M_BR.P$15 (OUT_B), M_BR.P$16 (OUT_B), M_BR.P$17 (OUT_B), M_BR.P$18 (OUT_B), M_BR.SLUG3 (OUT_B)
BR_PWM: M4R7.1, M4R11.2; also elsewhere on the board
FL_CS: M1C1.1, M1R8.1; also elsewhere on the board
FL_DIR: M1R5.1, MU1.1 (1A); also elsewhere on the board
FL_OUTA: M1D1.C, M1D2.A, M1J1.+ (P$V+), M_FL.P1 (OUT_A), M_FL.P25 (OUT_A), M_FL.P30 (OUT_A), M_FL.P$1 (OUT_A), M_FL.P$2 (OUT_A), M_FL.P$3 (OUT_A), M_FL.P$4 (OUT_A), M_FL.P$5 (OUT_A), M_FL.P$6 (OUT_A), M_FL.P$7 (OUT_A), M_FL.P$8 (OUT_A), M_FL.P$9 (OUT_A), M_FL.SLUG2 (OUT_A)
FL_OUTB: M1J1.- (P$V-), M1R12.2, M_FL.P15 (OUT_B), M_FL.P16 (OUT_B), M_FL.P21 (OUT_B), M_FL.P$10 (OUT_B), M_FL.P$11 (OUT_B), M_FL.P$12 (OUT_B), M_FL.P$13 (OUT_B), M_FL.P$14 (OUT_B), M_FL.P$15 (OUT_B), M_FL.P$16 (OUT_B), M_FL.P$17 (OUT_B), M_FL.P$18 (OUT_B), M_FL.SLUG3 (OUT_B)
FL_PWM: M1R7.1, M1R11.2; also elsewhere on the board
FR_CS: M2C1.1, M2R8.1; also elsewhere on the board
FR_DIR: M2R5.1, MU1.3 (2A); also elsewhere on the board
FR_OUTA: M2D1.C, M2D2.A, M2J1.+ (P$V+), M_FR.P1 (OUT_A), M_FR.P25 (OUT_A), M_FR.P30 (OUT_A), M_FR.P$1 (OUT_A), M_FR.P$2 (OUT_A), M_FR.P$3 (OUT_A), M_FR.P$4 (OUT_A), M_FR.P$5 (OUT_A), M_FR.P$6 (OUT_A), M_FR.P$7 (OUT_A), M_FR.P$8 (OUT_A), M_FR.P$9 (OUT_A), M_FR.SLUG2 (OUT_A)
FR_OUTB: M2J1.- (P$V-), M2R12.2, M_FR.P15 (OUT_B), M_FR.P16 (OUT_B), M_FR.P21 (OUT_B), M_FR.P$10 (OUT_B), M_FR.P$11 (OUT_B), M_FR.P$12 (OUT_B), M_FR.P$13 (OUT_B), M_FR.P$14 (OUT_B), M_FR.P$15 (OUT_B), M_FR.P$16 (OUT_B), M_FR.P$17 (OUT_B), M_FR.P$18 (OUT_B), M_FR.SLUG3 (OUT_B)
FR_PWM: M2R7.1, M2R11.2; also elsewhere on the board
GND: 3C1.2, 3C2.2, GND_M2B.P$1, GND_M4B.P$1, M1C1.2, M1C2.2 (-), M1C3.2, M1R9.1, M1R10.1, M1R11.1, M2C1.2, M2R9.1, M2R10.1, M2R11.1, M3C1.2, M3C2.2 (-), M3C3.2, M3R9.1, M3R10.1, M3R11.1, M4C1.2, M4R9.1, M4R10.1, M4R11.1, MU1.2 (GND), MU2.2 (GND), M_BL.P18 (GND), M_BL.P19 (GND), M_BL.P20 (GND), M_BL.P26 (GND), M_BL.P27 (GND), M_BL.P28 (GND), M_FL.P18 (GND), M_FL.P19 (GND), M_FL.P20 (GND), M_FL.P26 (GND), M_FL.P27 (GND), M_FL.P28 (GND), S3.1 (O); also elsewhere on the board
GND_M: GND_M2A.P$1, GND_M4A.P$1, M2C2.2 (-), M2C3.2, M4C2.2 (-), M4C3.2, M_BR.P18 (GND), M_BR.P19 (GND), M_BR.P20 (GND), M_BR.P26 (GND), M_BR.P27 (GND), M_BR.P28 (GND), M_FR.P18 (GND), M_FR.P19 (GND), M_FR.P20 (GND), M_FR.P26 (GND), M_FR.P27 (GND), M_FR.P28 (GND)
M_SWITCH: M1R1.1, M1R2.1, M2R1.1, M2R2.1, M3R1.1, M3R2.1, M4R1.1, M4R2.1, S3.2
unnamed: M1R1.2, M1R4.1, M_FL.P5 (EN_A)
unnamed: M1R2.2, M1R3.1, M_FL.P9 (EN_B)
unnamed: M1R5.2, M_FL.P4 (IN_A)
unnamed: M1R6.2, M_FL.P10 (IN_B)
unnamed: M1R7.2, M_FL.P7 (PWM_IN)
unnamed: M1R8.2, M1R10.2, M_FL.P8 (CS)
unnamed: M1R9.2, M_FL.P6 (CS_DIS)
unnamed: M1C2.1 (+), M1C3.1, M1Q1.4 (D), M_FL.P3 (VCC), M_FL.P13 (VCC), M_FL.P23 (VCC), M_FL.P$19 (VCC), M_FL.P$20 (VCC), M_FL.P$21 (VCC), M_FL.P$22 (VCC), M_FL.P$23 (VCC), M_FL.P$24 (VCC), M_FL.P$25 (VCC), M_FL.P$26 (VCC), M_FL.P$27 (VCC), M_FL.P$28 (VCC), M_FL.SLUG1 (VCC)
unnamed: M1Q1.1 (G), M_FL.P11 (CP)
unnamed: M2R2.2, M2R3.1, M_FR.P9 (EN_B)
unnamed: M1D1.A, M1D2.C, M1R12.1
unnamed: M2R1.2, M2R4.1, M_FR.P5 (EN_A)
unnamed: M2R6.2, M_FR.P10 (IN_B)
unnamed: M2R5.2, M_FR.P4 (IN_A)
unnamed: M2R7.2, M_FR.P7 (PWM_IN)
unnamed: M2R8.2, M2R10.2, M_FR.P8 (CS)
unnamed: M2R9.2, M_FR.P6 (CS_DIS)
unnamed: M2C2.1 (+), M2C3.1, M2Q1.4 (D), M_FR.P3 (VCC), M_FR.P13 (VCC), M_FR.P23 (VCC), M_FR.P$19 (VCC), M_FR.P$20 (VCC), M_FR.P$21 (VCC), M_FR.P$22 (VCC), M_FR.P$23 (VCC), M_FR.P$24 (VCC), M_FR.P$25 (VCC), M_FR.P$26 (VCC), M_FR.P$27 (VCC), M_FR.P$28 (VCC), M_FR.SLUG1 (VCC)
unnamed: M2Q1.1 (G), M_FR.P11 (CP)
unnamed: M3R2.2, M3R3.1, M_BL.P9 (EN_B)
unnamed: M2D1.A, M2D2.C, M2R12.1
unnamed: M3R1.2, M3R4.1, M_BL.P5 (EN_A)
unnamed: M3R6.2, M_BL.P10 (IN_B)
unnamed: M3R5.2, M_BL.P4 (IN_A)
unnamed: M3R7.2, M_BL.P7 (PWM_IN)
unnamed: M3R8.2, M3R10.2, M_BL.P8 (CS)
unnamed: M3R9.2, M_BL.P6 (CS_DIS)
unnamed: M3C2.1 (+), M3C3.1, M3Q1.4 (D), M_BL.P3 (VCC), M_BL.P13 (VCC), M_BL.P23 (VCC), M_BL.P$19 (VCC), M_BL.P$20 (VCC), M_BL.P$21 (VCC), M_BL.P$22 (VCC), M_BL.P$23 (VCC), M_BL.P$24 (VCC), M_BL.P$25 (VCC), M_BL.P$26 (VCC), M_BL.P$27 (VCC), M_BL.P$28 (VCC), M_BL.SLUG1 (VCC)
unnamed: M3Q1.1 (G), M_BL.P11 (CP)
unnamed: M4R2.2, M4R3.1, M_BR.P9 (EN_B)
unnamed: M4R1.2, M4R4.1, M_BR.P5 (EN_A)
unnamed: M4R6.2, M_BR.P10 (IN_B)
unnamed: M4R5.2, M_BR.P4 (IN_A)
unnamed: M4R7.2, M_BR.P7 (PWM_IN)
unnamed: M3D1.A, M3D2.C, M3R12.1
unnamed: M4R8.2, M4R10.2, M_BR.P8 (CS)
unnamed: M4R9.2, M_BR.P6 (CS_DIS)
unnamed: M4C2.1 (+), M4C3.1, M4Q1.4 (D), M_BR.P3 (VCC), M_BR.P13 (VCC), M_BR.P23 (VCC), M_BR.P$19 (VCC), M_BR.P$20 (VCC), M_BR.P$21 (VCC), M_BR.P$22 (VCC), M_BR.P$23 (VCC), M_BR.P$24 (VCC), M_BR.P$25 (VCC), M_BR.P$26 (VCC), M_BR.P$27 (VCC), M_BR.P$28 (VCC), M_BR.SLUG1 (VCC)
unnamed: M4Q1.1 (G), M_BR.P11 (CP)
unnamed: M4D1.A, M4D2.C, M4R12.1
NOT_BL_DIR: M3R6.1, MU2.6 (1Y)
NOT_BR_DIR: M4R6.1, MU2.4 (2Y)
NOT_FL_DIR: M1R6.1, MU1.6 (1Y)
NOT_FR_DIR: M2R6.1, MU1.4 (2Y)
V_BATT: M1Q1.3 (S), M2Q1.3 (S), M3Q1.3 (S), M4Q1.3 (S), M_BL.P12 (VBAT), M_BR.P12 (VBAT), M_FL.P12 (VBAT), M_FR.P12 (VBAT), V_BATT_M1A.P$1, V_BATT_M1B.P$1, V_BATT_M2A.P$1, V_BATT_M2B.P$1, V_BATT_M3A.P$1, V_BATT_M3B.P$1, V_BATT_M4A.P$1, V_BATT_M4B.P$1; also elsewhere on the board

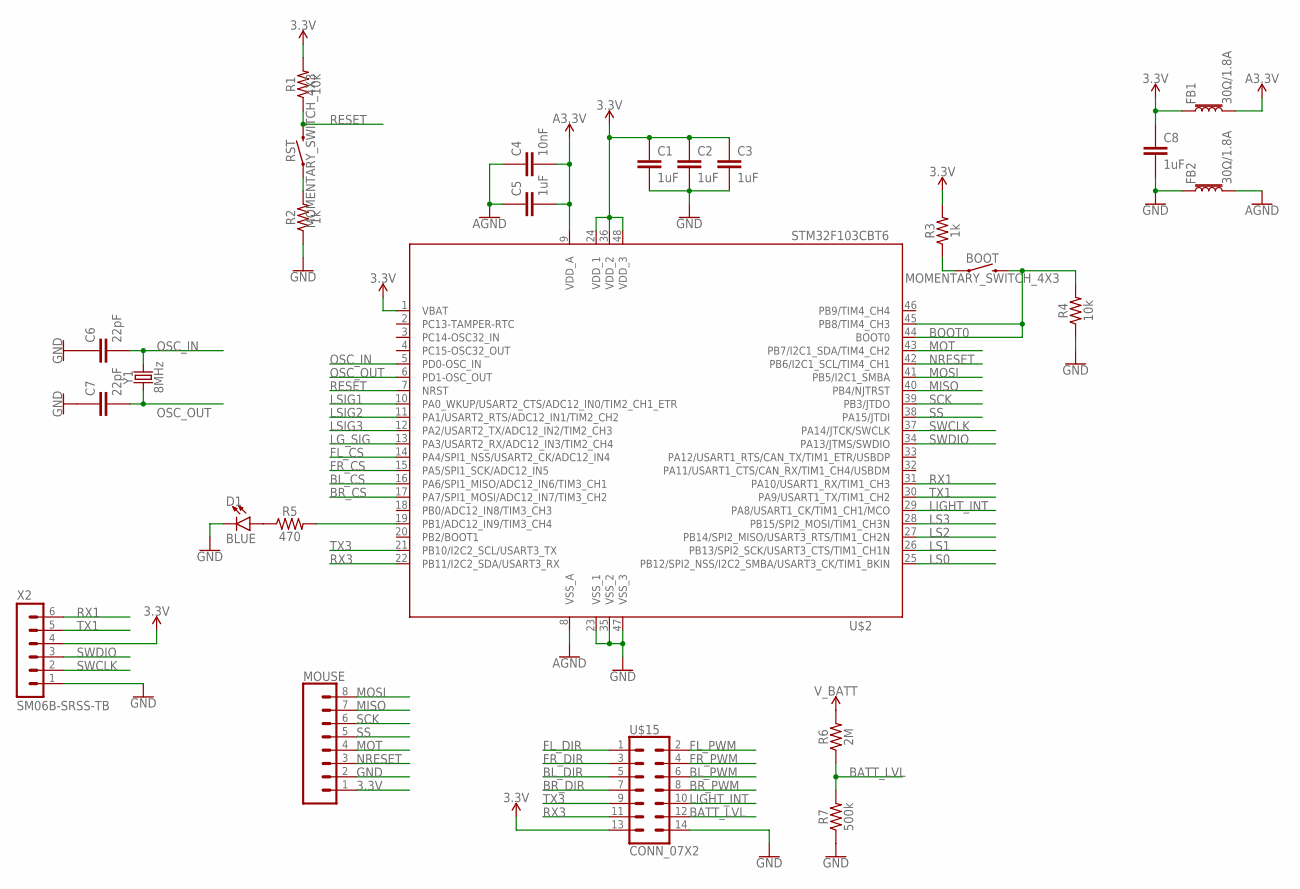
[picture p16: schematic Layer 1.sch, sheet 4]

Parts:
BOOT: MOMENTARY_SWITCH_4X3
C1, C2, C3, C5, C8: 1uF; C0603
C4: 10nF; C0603
C6, C7: 22pF; C0603
D1: BLUE; LED-0603
FB1, FB2: 30Ω/1.8A; 0603
MOUSE: CONN_08LOCK; 1X08_LOCK
R1, R4: 10k; R0603
R2, R3: 1k; R0603
R5: 470; R0603
R6: 2M; R0603
R7: 500k; R0603
RST: MOMENTARY_SWITCH_4X3
U$2: STM32F103CBT6; LQFP48
U$15: CONN_07X2; 2X7
X2: SM06B-SRSS-TB
Y1: 8MHz; CRYSTAL-SMD-5X3.2-2PAD

Connections:
3.3V: C1.1, C2.1, C3.1, C8.1, FB1.1, MOUSE.1, R1.2, R3.2, U$2.1 (VBAT), U$2.24 (VDD_1), U$2.36 (VDD_2), U$2.48 (VDD_3), U$15.13, X2.4; also elsewhere on the board
AGND: C4.1, C5.1, FB2.2, U$2.8 (VSS_A); also elsewhere on the board
BATT_LVL: R6.1, R7.2, U$15.12
BL_CS: U$2.16 (PA6/SPI1_MISO/ADC12_IN6/TIM3_CH1); also elsewhere on the board
BL_DIR: U$15.5; also elsewhere on the board
BL_PWM: U$15.6; also elsewhere on the board
BOOT0: BOOT.P$2 (2), R4.2, U$2.44 (BOOT0), U$2.45 (PB8/TIM4_CH3)
BR_CS: U$2.17 (PA7/SPI1_MOSI/ADC12_IN7/TIM3_CH2); also elsewhere on the board
BR_DIR: U$15.7; also elsewhere on the board
BR_PWM: U$15.8; also elsewhere on the board
FL_CS: U$2.14 (PA4/SPI1_NSS/USART2_CK/ADC12_IN4); also elsewhere on the board
FL_DIR: U$15.1; also elsewhere on the board
FL_PWM: U$15.2; also elsewhere on the board
FR_CS: U$2.15 (PA5/SPI1_SCK/ADC12_IN5); also elsewhere on the board
FR_DIR: U$15.3; also elsewhere on the board
FR_PWM: U$15.4; also elsewhere on the board
GND: C1.2, C2.2, C3.2, C6.1, C7.1, C8.2, D1.C, FB2.1, MOUSE.2, R2.1, R4.1, R7.1, U$2.23 (VSS_1), U$2.35 (VSS_2), U$2.47 (VSS_3), U$15.14, X2.1; also elsewhere on the board
LG_SIG: U$2.13 (PA3/USART2_RX/ADC12_IN3/TIM2_CH4); also elsewhere on the board
LIGHT_INT: U$2.29 (PA8/USART1_CK/TIM1_CH1/MCO), U$15.10
LS0: U$2.25 (PB12/SPI2_NSS/I2C2_SMBA/USART3_CK/TIM1_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); also elsewhere on the board
LS1: U$2.26 (PB13/SPI2_SCK/USART3_CTS/TIM1_CH1N); also elsewhere on the board
LS2: U$2.27 (PB14/SPI2_MISO/USART3_RTS/TIM1_CH2N); also elsewhere on the board
LS3: U$2.28 (PB15/SPI2_MOSI/TIM1_CH3N); also elsewhere on the board
LSIG1: U$2.10 (PA0_WKUP/USART2_CTS/ADC12_IN0/TIM2_CH1_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); also elsewhere on the board
LSIG2: U$2.11 (PA1/USART2_RTS/ADC12_IN1/TIM2_CH2); also elsewhere on the board
LSIG3: U$2.12 (PA2/USART2_TX/ADC12_IN2/TIM2_CH3); also elsewhere on the board
MISO: MOUSE.7, U$2.40 (PB4/NJTRST)
MOSI: MOUSE.8, U$2.41 (PB5/I2C1_SMBA)
MOT: MOUSE.4, U$2.43 (PB7/I2C1_SDA/TIM4_CH2)
unnamed: R2.2, RST.P$1 (1)
unnamed: BOOT.P$1 (1), R3.1
unnamed: R5.2, U$2.19 (PB1/ADC12_IN9/TIM3_CH4)
unnamed: D1.A, R5.1
NRESET: MOUSE.3, U$2.42 (PB6/I2C1_SCL/TIM4_CH1)
OSC_IN: C6.2, U$2.5 (PD0-OSC_IN), Y1.P$2 (2)
OSC_OUT: C7.2, U$2.6 (PD1-OSC_OUT), Y1.P$1 (1)
RESET: R1.1, RST.P$2 (2), U$2.7 (NRST)
RX1: U$2.31 (PA10/USART1_RX/TIM1_CH3), X2.6
RX3: U$2.22 (PB11/I2C2_SDA/USART3_RX), U$15.11
SCK: MOUSE.6, U$2.39 (PB3/JTDO)
SS: MOUSE.5, U$2.38 (PA15/JTDI)
SWCLK: U$2.37 (PA14/JTCK/SWCLK), X2.2
SWDIO: U$2.34 (PA13/JTMS/SWDIO), X2.3
TX1: U$2.30 (PA9/USART1_TX/TIM1_CH2), X2.5
TX3: U$2.21 (PB10/I2C2_SCL/USART3_TX), U$15.9
VCCA: C4.2, C5.2, FB1.2, U$2.9 (VDD_A); also elsewhere on the board
V_BATT: R6.2; also elsewhere on the board

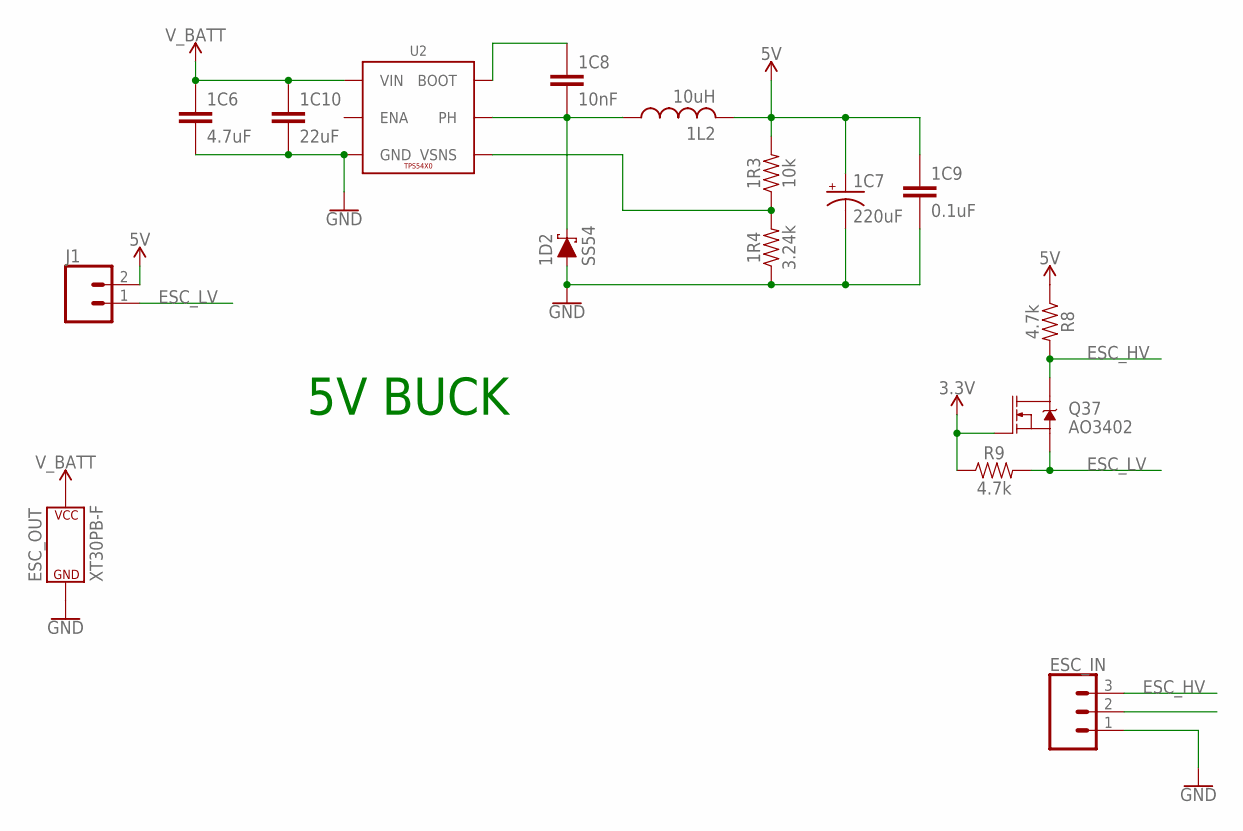
[picture p17: schematic Layer 1.sch, sheet 5]

Parts:
1C6: 4.7uF; C0603
1C7: 220uF; EIA7343
1C8: 10nF; C0603
1C9: 0.1uF; C0603
1C10: 22uF; C1210
1D2: SS54; SMA-DIODE
1L2: 10uH; SWPA8040
1R3: 10k; R0603
1R4: 3.24k; R0603
ESC_IN: CONN_03LOCK; 1X03_LOCK
ESC_OUT: XT30PB-F
J1: CONN_02LOCK; 1X02_LOCK
Q37: AO3402; SOT23-3
R8, R9: 4.7k; R0603
U2: TPS54X0; POWERPAD-SOIC-8

Connections:
3.3V1: Q37.1 (G), R9.1
5V: 1C7.A (+), 1C9.1, 1L2.P2 (2), 1R3.2, J1.2, R8.1
ESC_HV: ESC_IN.3, Q37.3 (D), R8.2
ESC_LV: J1.1, Q37.2 (S), R9.2
GND: 1C6.2, 1C7.C (-), 1C9.2, 1C10.2, 1D2.A, 1R4.1, ESC_IN.1, ESC_OUT.- (P$V-), U2.6 (GND), U2.9 (GND), U2.P$1 (GND), U2.P$2 (GND), U2.P$3 (GND), U2.P$4 (GND), U2.P$5 (GND), U2.P$6 (GND); also elsewhere on the board
unnamed: 1C8.2, 1D2.C, 1L2.P1 (1), U2.8 (PH)
unnamed: 1R3.1, 1R4.2, U2.4 (VSNS)
unnamed: 1C8.1, U2.1 (BOOT)
V_BATT: 1C6.1, 1C10.1, ESC_OUT.+ (P$V+), U2.7 (VIN); also elsewhere on the board

Notes on the sheet:
5V BUCK

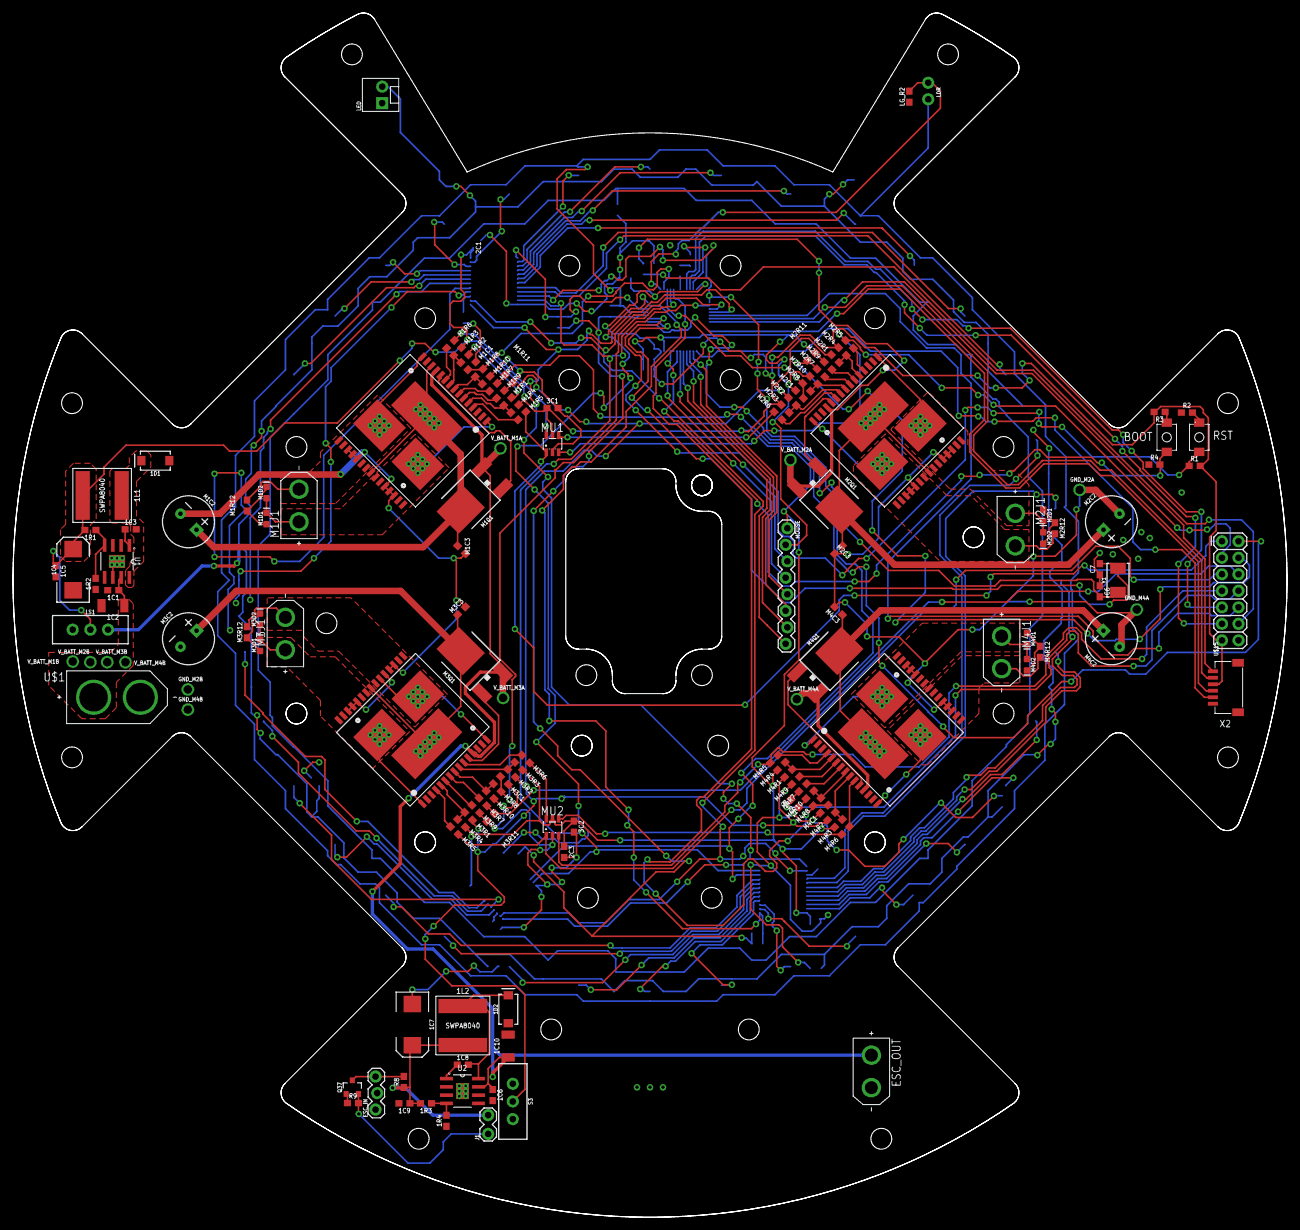
[picture p18: board Layer 1.brd from above]

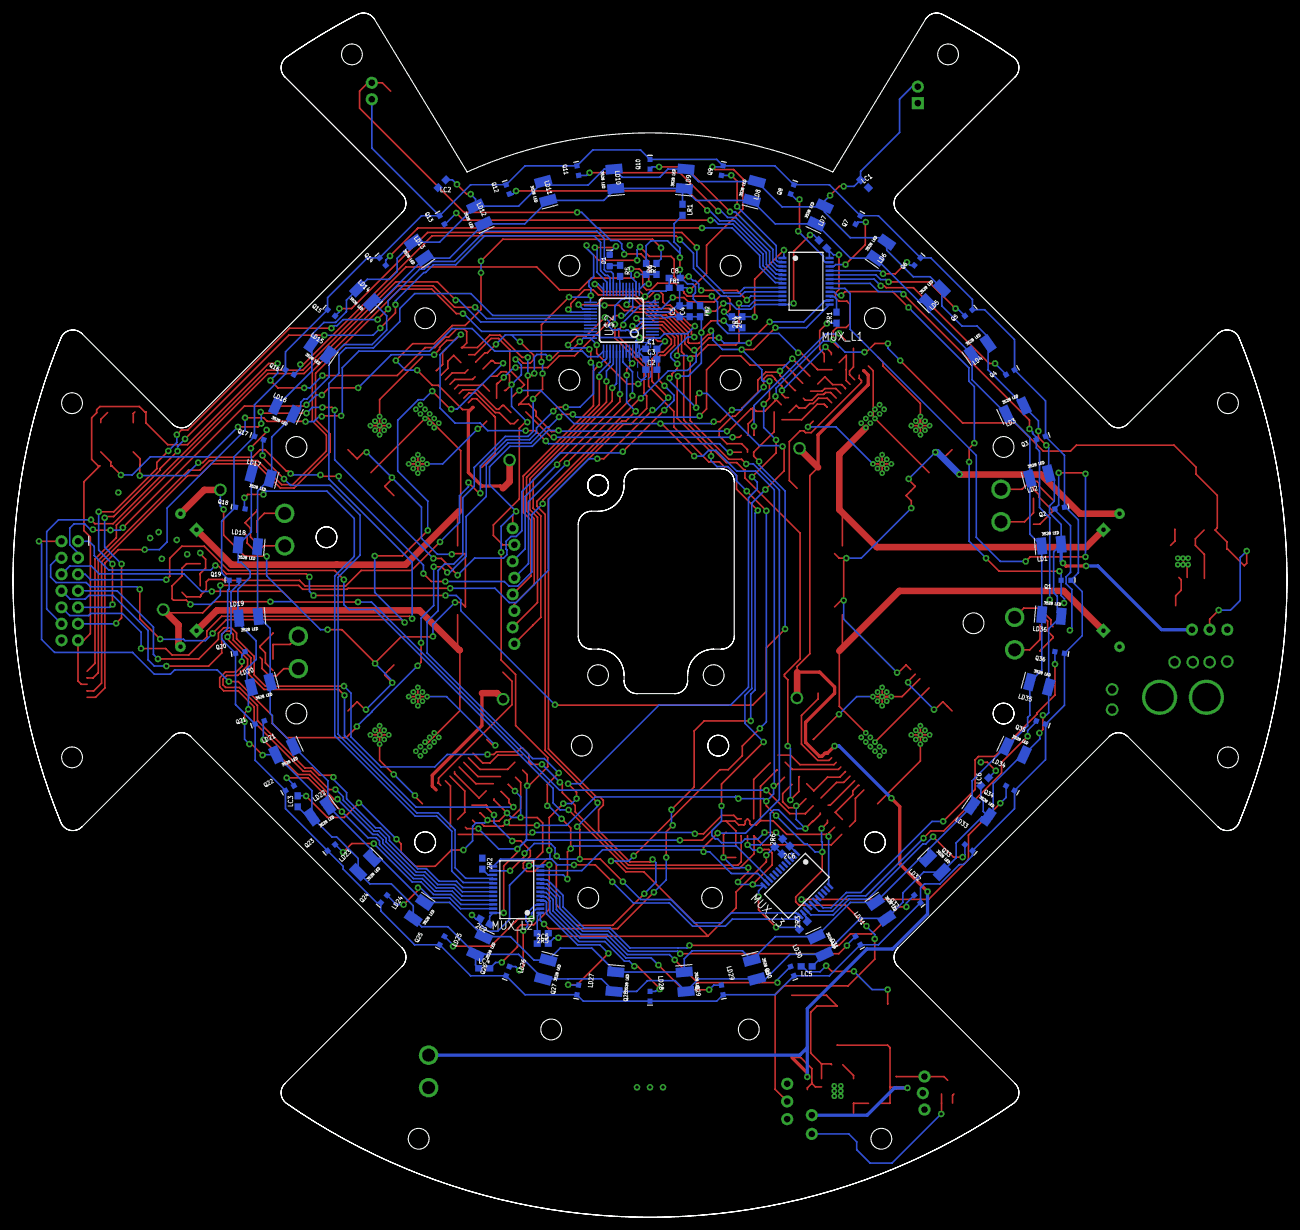
[picture p19: board Layer 1.brd from below]

Board: 2 copper layers, 196.0 x 185.3 mm, 247 parts (106 on the bottom side), 152 nets.
