Team-UwU-Robotics/Team-UwU/(commit log)

2021-01-15 ir sensor layer added (layer 3)
    [IR-Sensors.f3d]
2021-02-05 Layer 1
    [layer1.brd, layer1.sch]
2021-02-19 Fuck you
    [layer1.brd]
2021-02-28 Fucking Done
    [Layer 1.brd]
2021-03-01 Layer 1 ESC fix
2021-03-01 Revert "Layer 1 ESC fix"
    This reverts commit 0f488ec0a57c37762cb3c7e9928ac58a828ee823.
    [Layer 1.brd, Layer 1.sch]
2021-03-01 Include the part links
    [Part-List.xlsm]
